Davidrp23/LoRa-Smart-Irrigation-Network/docs/ExplanationDiagrams/DataTransmission_Unrecognized.pdf

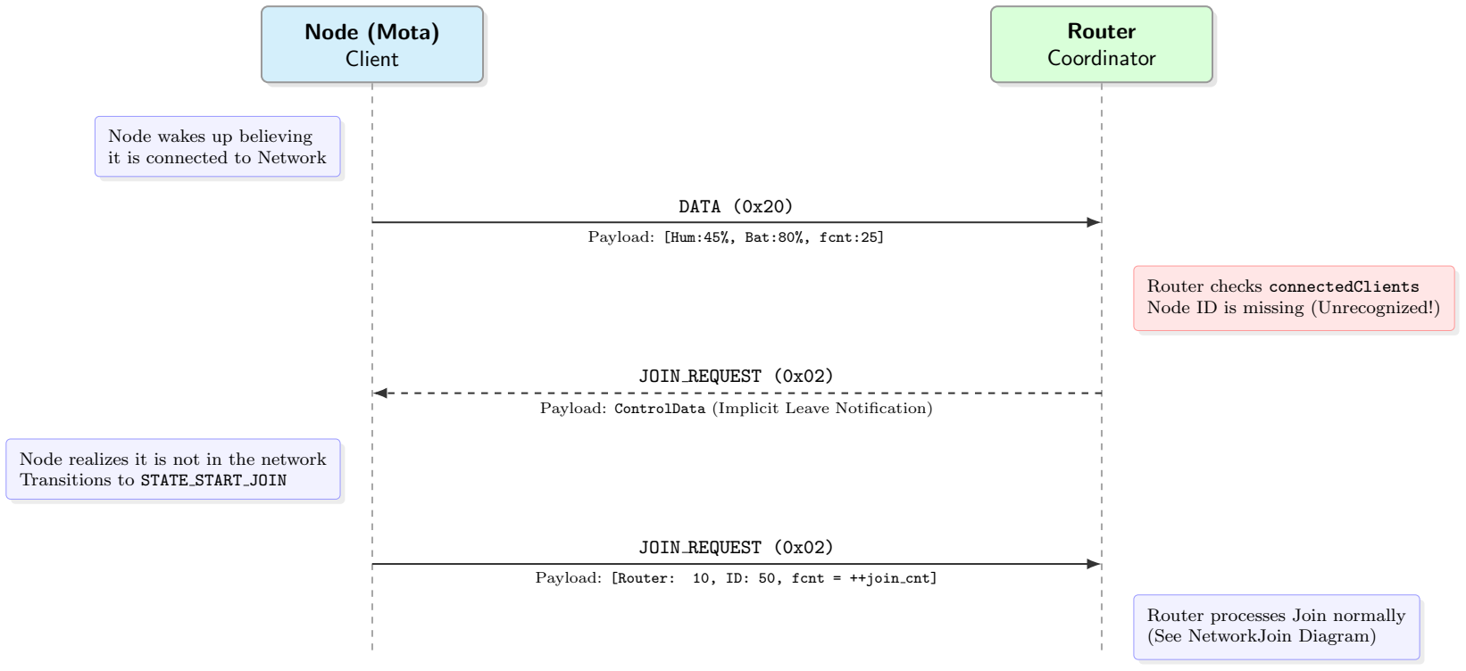
[picture p2: figure]
Node (Mota) Client; Router Coordinator; Node wakes up believing it is connected to Network; DATA (0x20); Payload: [Hum:45%, Bat:80%, fcnt:25]; Router checks connectedClients Node ID is missing (Unrecognized!); JOIN REQUEST (0x02); Payload: ControlData (Implicit Leave Notification); Node realizes it is not in the network Transitions to STATE START JOIN; Router processes Join normally (See NetworkJoin Diagram)

Payload: [Router: 10, ID: 50, fcnt = ++join cnt]

* Note: Payloads are shown in JSON/Plain-text format for clarity, but are transmitted as packed C-structs over LoRa to minimize time-on-air, battery usage, and collision probability.
