Davidrp23/LoRa-Smart-Irrigation-Network/docs/ExplanationDiagrams/esquemaProductorConsumidor.pdf

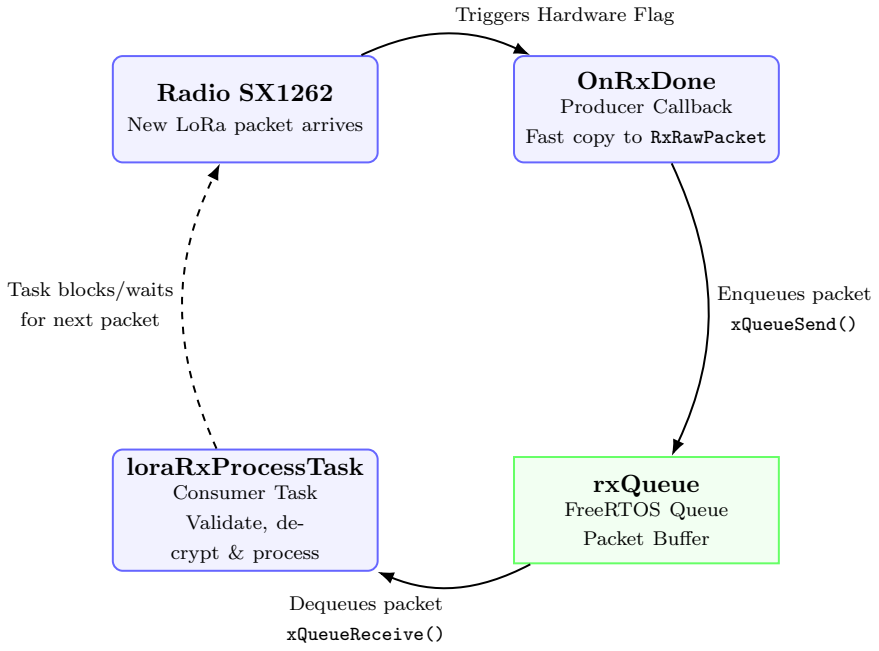
[picture p3: figure]
Radio SX1262; New LoRa packet arrives; OnRxDone; Producer Callback; Fast copy to RxRawPacket; rxQueue; FreeRTOS Queue; Packet Buffer; loraRxProcessTask; Consumer Task; Validate, de-; crypt & process; Triggers Hardware Flag; Enqueues packet; xQueueSend(); Dequeues packet; xQueueReceive(); Task blocks/waits; for next packet
