Davidrp23/LoRa-Smart-Irrigation-Network/docs/ExplanationDiagrams/LoRaMessageFrame.pdf

HEADER (8 bytes — plaintext) | PAYLOAD (up to 50 bytes — AES-128-CTR encrypted)
type | length | fcnt | checksum | data (union)
B0 | B1 | B2 | B6 | B8 | B57
1 B | 1 B | 4 B | 2 B | ≤50 B
Field | Type | Description
type | messageType (1 B) | Message kind: tells the receiver how to parse data
length | uint8 t | (1 B) | Valid bytes in data. Enables dynamic-length transmissions
fcnt | uint32 t (4 B) | Frame Counter: anti-replay guard and AES-128 IV source
checksum | uint16 t (2 B) | | Packet integrity check against RF corruption
data | union | (≤50 B) | Encrypted payload. Structure depends on type

Only bytes B0–B(8+length−1) are transmitted over the air. Unused trailing bytes in data are discarded before sending.
