Davidrp23/LoRa-Smart-Irrigation-Network/docs/photos/Proxmox/flora-system-sumary.png

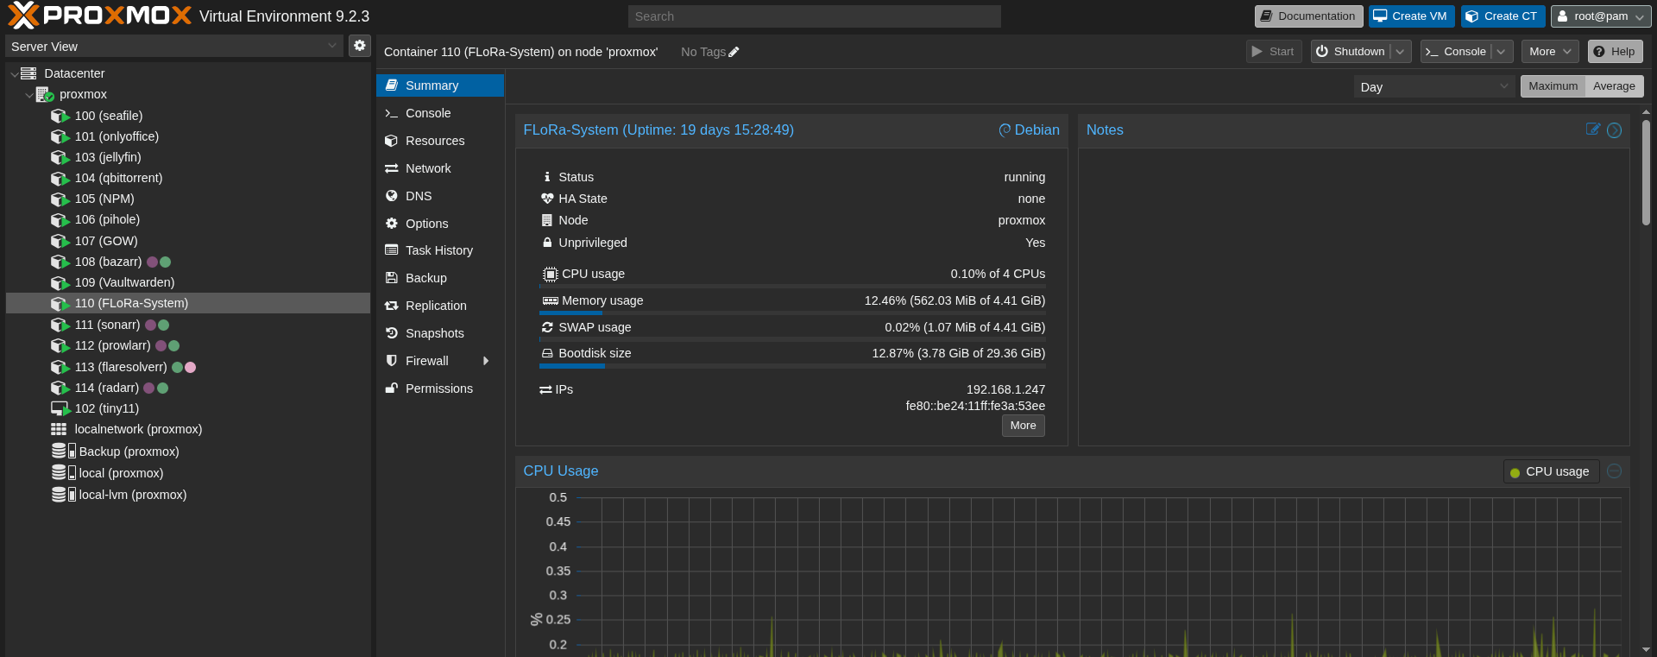
docs/photos/Proxmox/flora-system-sumary.png
