Davidrp23/LoRa-Smart-Irrigation-Network/docs/photos/Proxmox/npm/certificadosSSLConfDominioFlora.png

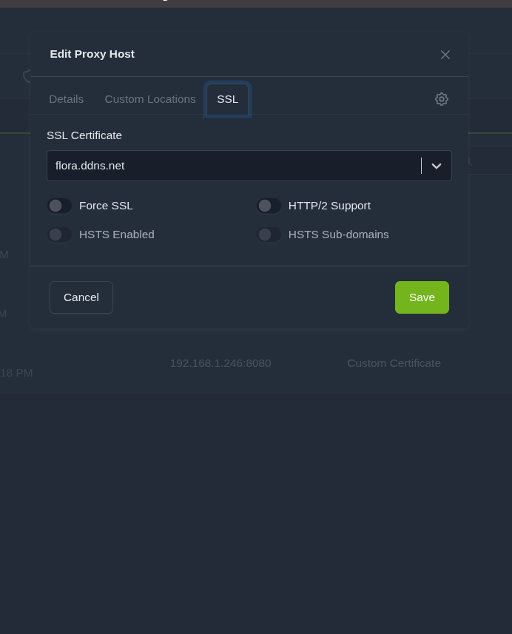
docs/photos/Proxmox/npm/certificadosSSLConfDominioFlora.png
