Davidrp23/LoRa-Smart-Irrigation-Network/docs/photos/Proxmox/npm/letsEncrypt.png

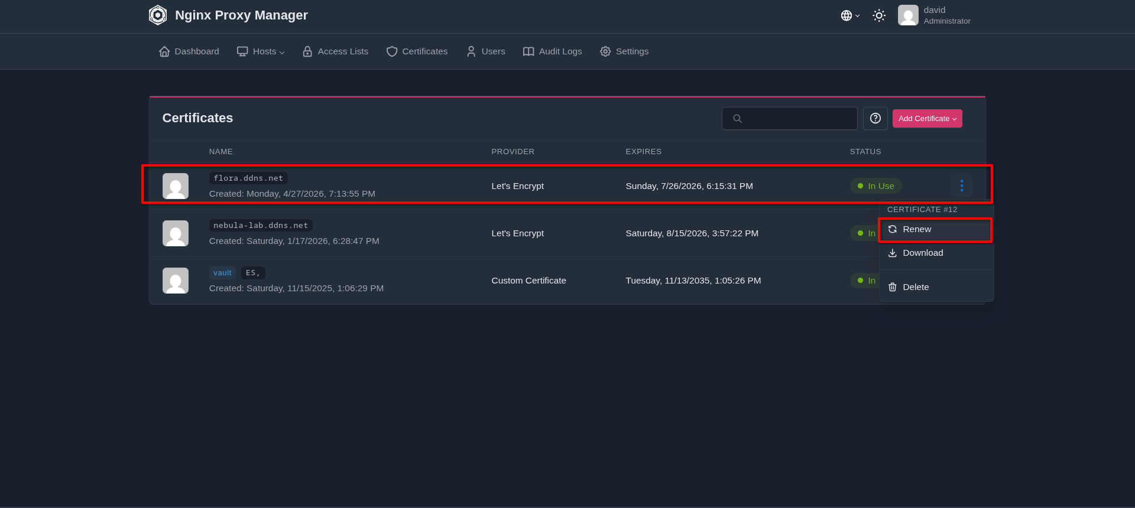
docs/photos/Proxmox/npm/letsEncrypt.png
