Davidrp23/LoRa-Smart-Irrigation-Network/docs/photos/Proxmox/npm/proxyHostSumary.png

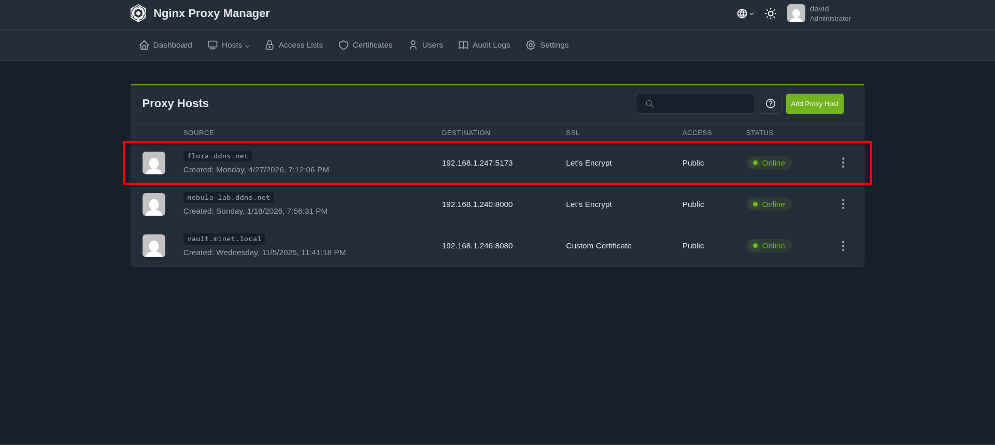
docs/photos/Proxmox/npm/proxyHostSumary.png
