Davidrp23/LoRa-Smart-Irrigation-Network/docs/photos/Proxmox/npm/rutasNPM.png

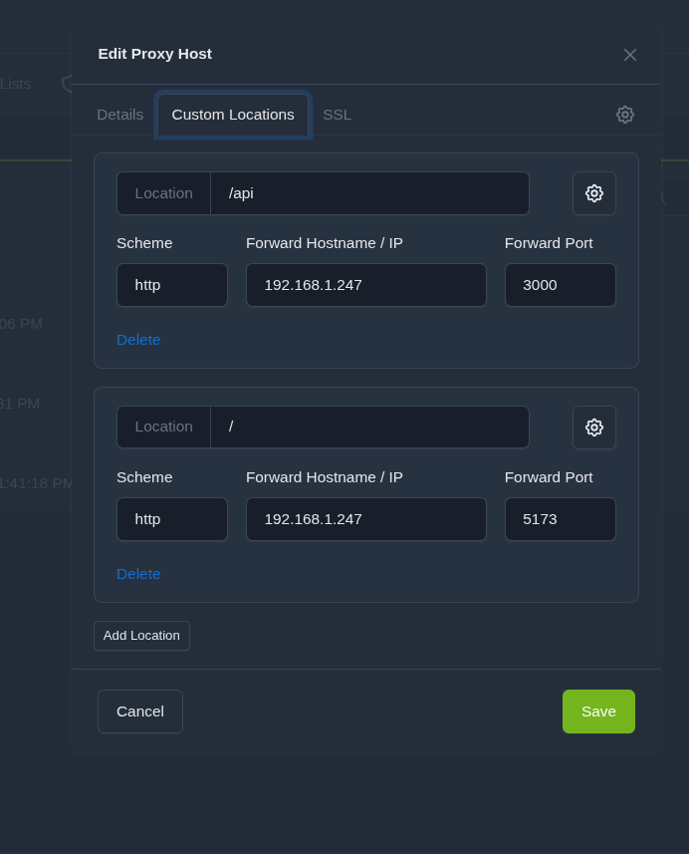
docs/photos/Proxmox/npm/rutasNPM.png
