Davidrp23/LoRa-Smart-Irrigation-Network/docs/photos/Proxmox/nvidia-smi.png

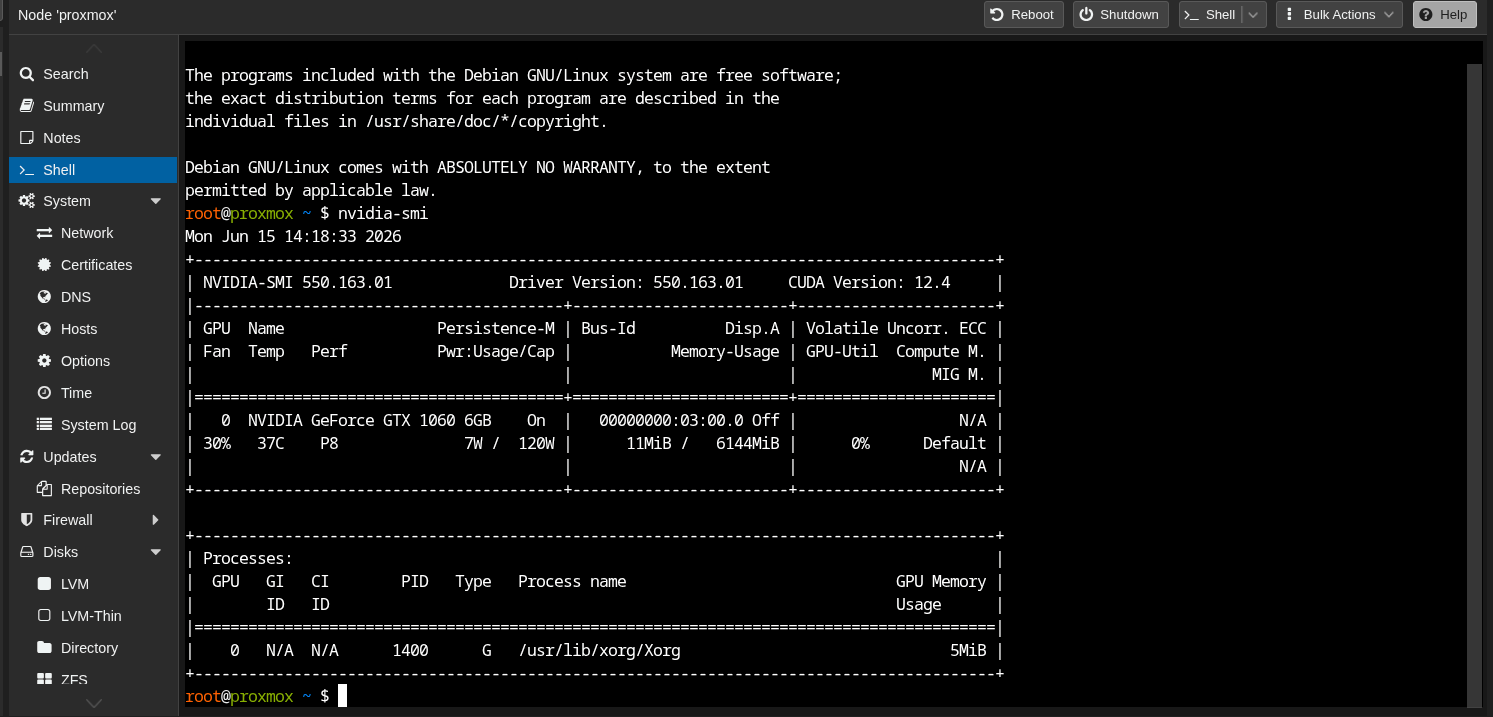
docs/photos/Proxmox/nvidia-smi.png
