Davidrp23/LoRa-Smart-Irrigation-Network/docs/photos/Proxmox/pm2.png

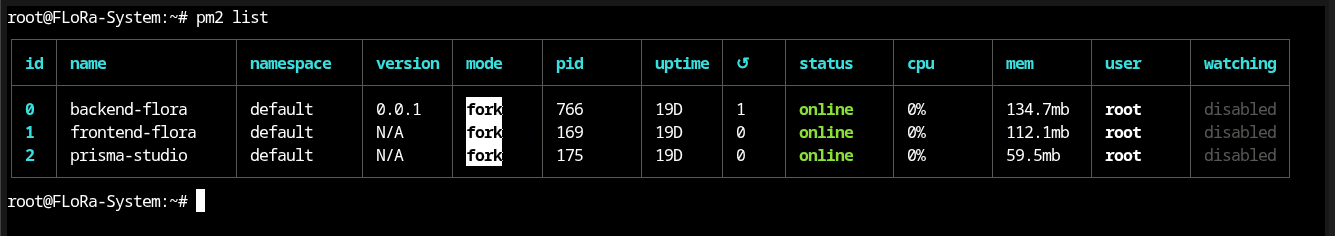
docs/photos/Proxmox/pm2.png
