Davidrp23/LoRa-Smart-Irrigation-Network/docs/photos/Proxmox/Server.png

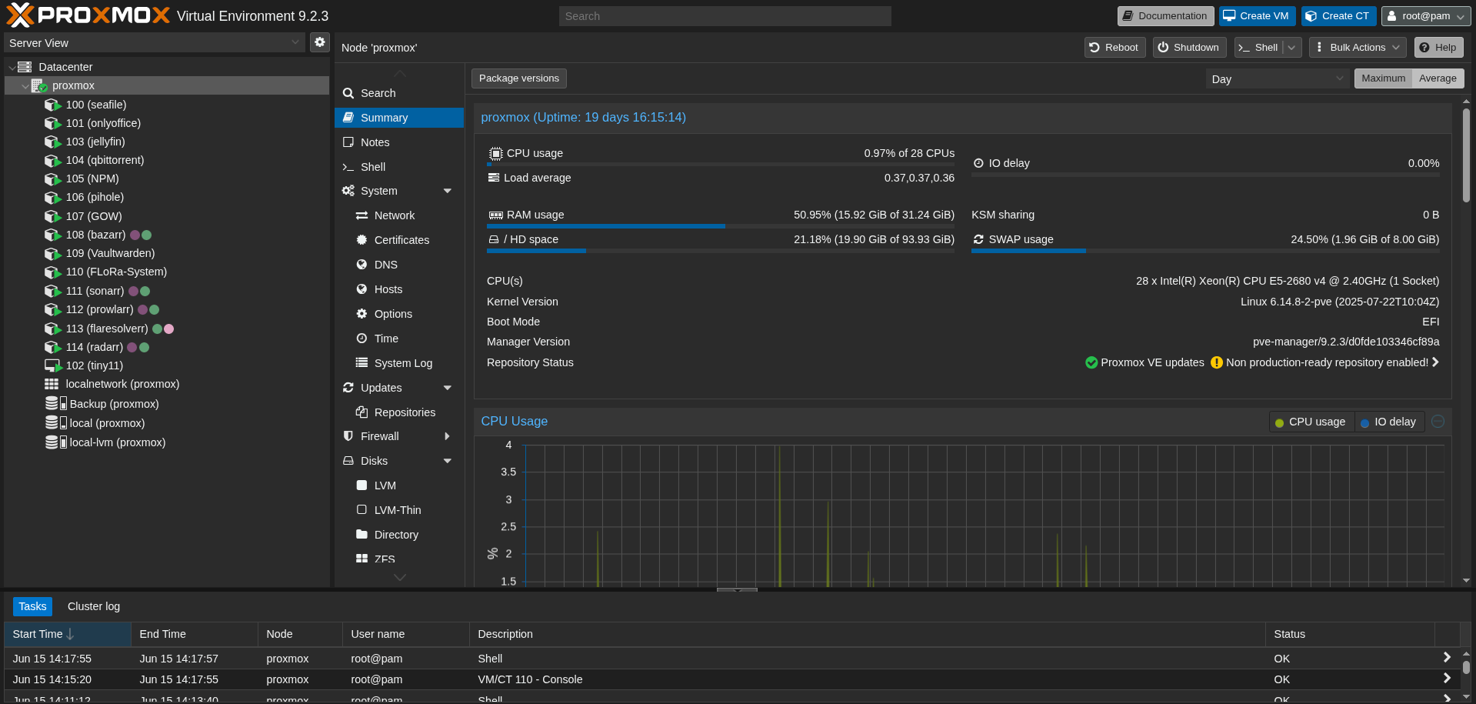
docs/photos/Proxmox/Server.png
