Davidrp23/LoRa-Smart-Irrigation-Network/docs/photos/WEB_UI/DARK/pasted file12.png

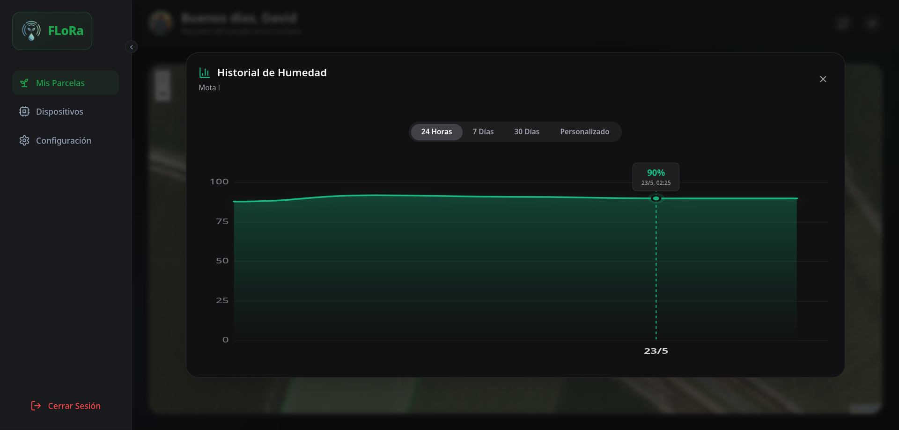
docs/photos/WEB_UI/DARK/pasted file12.png
