Davidrp23/LoRa-Smart-Irrigation-Network/docs/photos/WEB_UI/DARK/Screenshot_20260523_111758.png

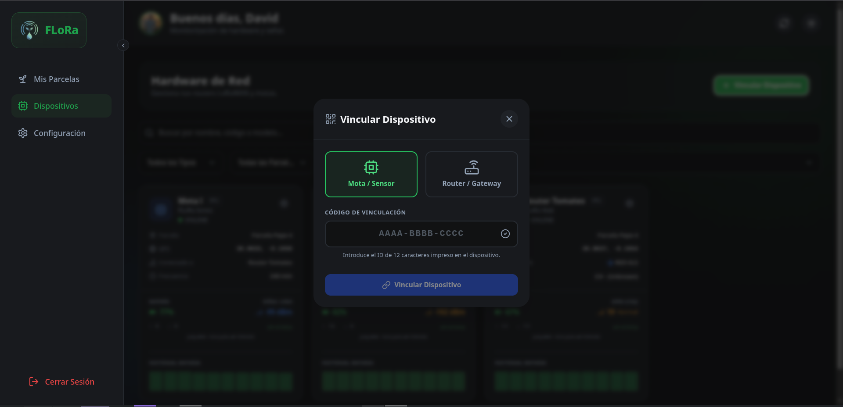
docs/photos/WEB_UI/DARK/Screenshot_20260523_111758.png
