Davidrp23/LoRa-Smart-Irrigation-Network/docs/photos/WEB_UI/DARK/Screenshot_20260601_191418.png

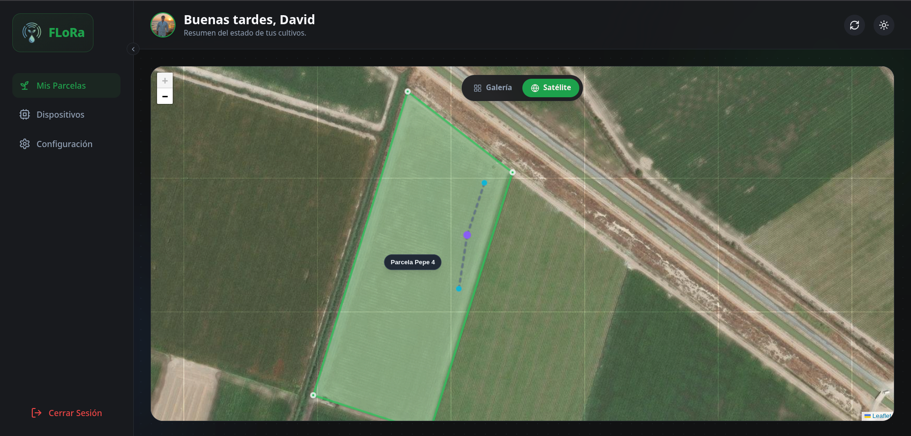
docs/photos/WEB_UI/DARK/Screenshot_20260601_191418.png
