Davidrp23/LoRa-Smart-Irrigation-Network/docs/photos/WEB_UI/DARK/Screenshot_20260615_121557.png

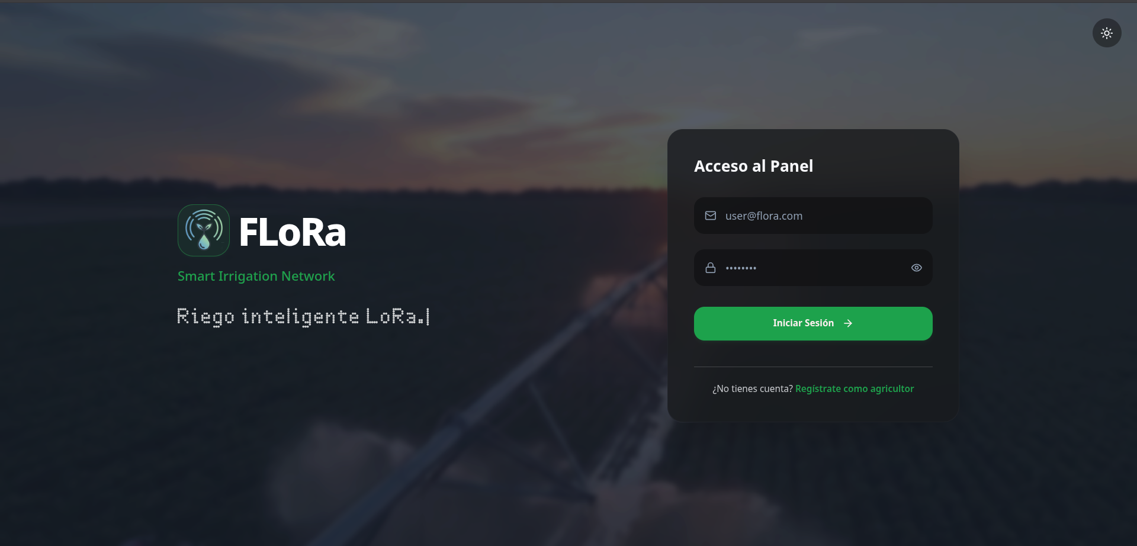
docs/photos/WEB_UI/DARK/Screenshot_20260615_121557.png
