Davidrp23/LoRa-Smart-Irrigation-Network/docs/photos/WEB_UI/LIGHT/Screenshot_20260615_124416.png

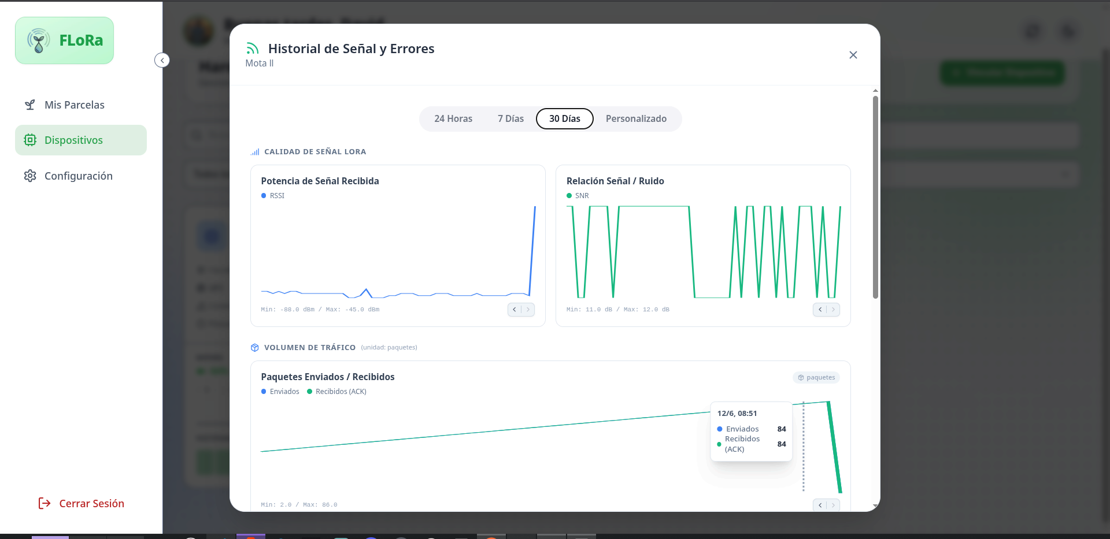
docs/photos/WEB_UI/LIGHT/Screenshot_20260615_124416.png
