Davidrp23/LoRa-Smart-Irrigation-Network/docs/ReporteFotograficoInstalacionCampo/Collage1.jpg

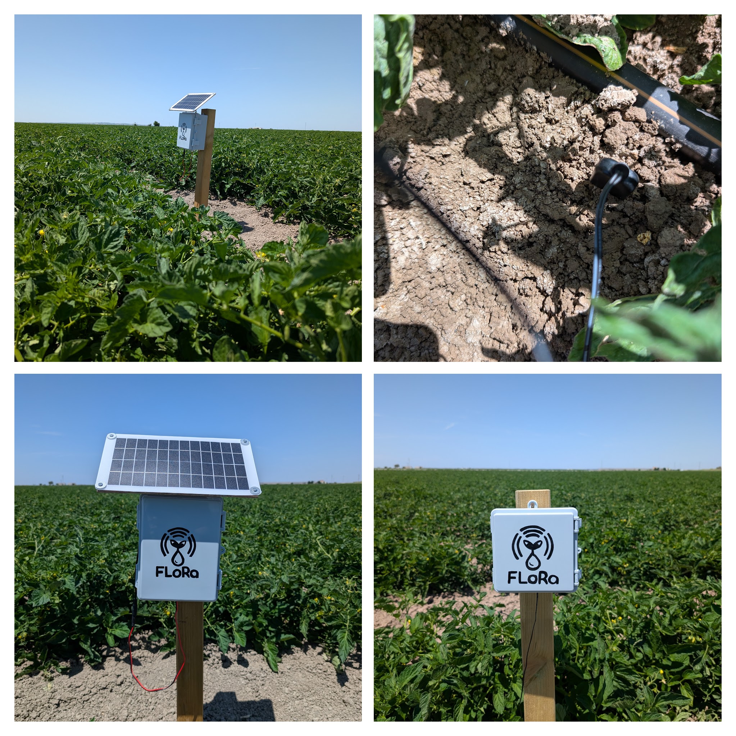
docs/ReporteFotograficoInstalacionCampo/Collage1.jpg
