Davidrp23/LoRa-Smart-Irrigation-Network/docs/ReporteFotograficoInstalacionCampo/collage2.jpg

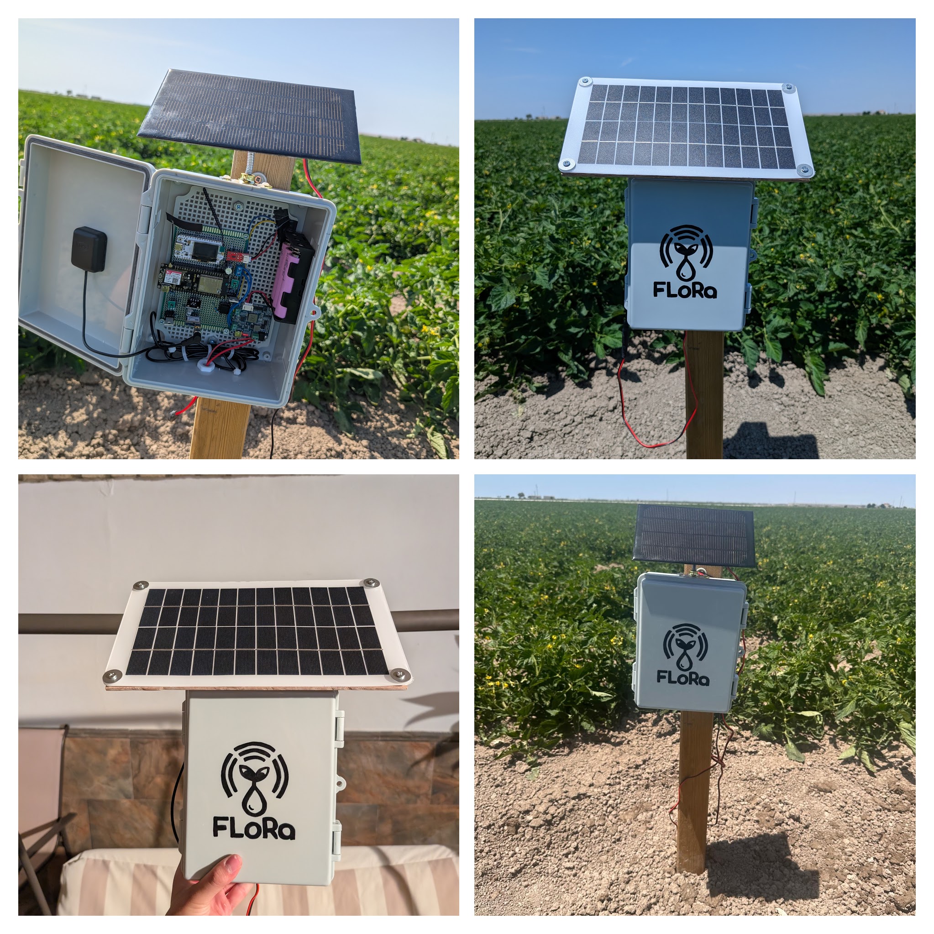
docs/ReporteFotograficoInstalacionCampo/collage2.jpg
