Davidrp23/LoRa-Smart-Irrigation-Network/docs/ReporteFotograficoInstalacionCampo/collage3.jpg

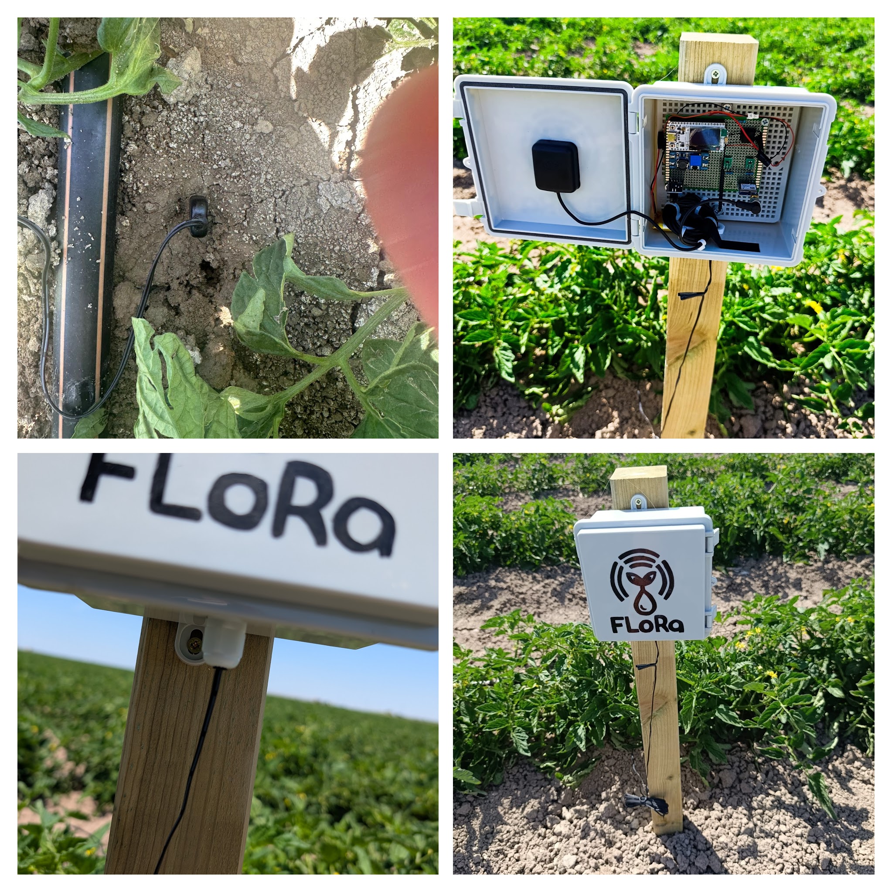
docs/ReporteFotograficoInstalacionCampo/collage3.jpg
