Davidrp23/LoRa-Smart-Irrigation-Network/docs/ReporteFotograficoInstalacionCampo/IMG-20260522-WA0014.jpg

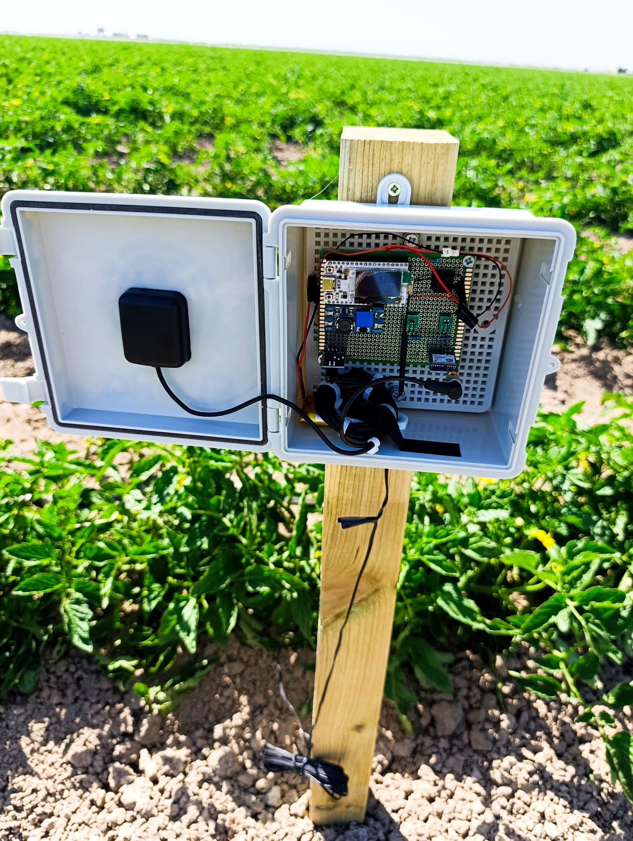
docs/ReporteFotograficoInstalacionCampo/IMG-20260522-WA0014.jpg
