Davidrp23/LoRa-Smart-Irrigation-Network/docs/ReporteFotograficoInstalacionCampo/PXL_20260522_151446291.jpg

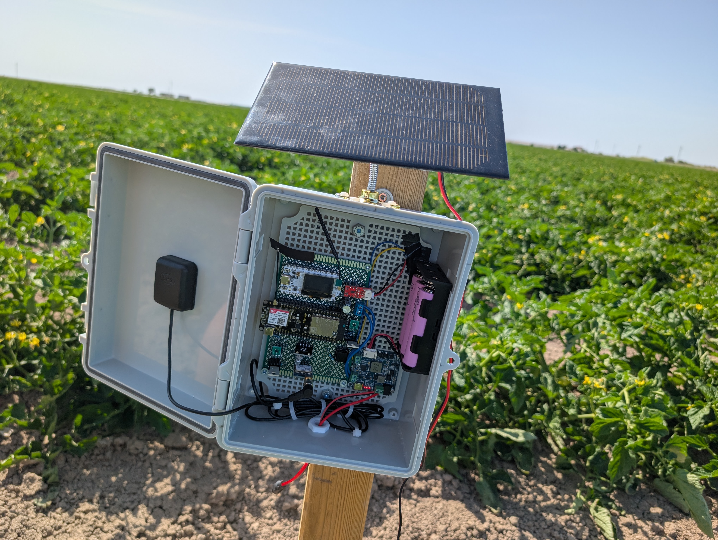
docs/ReporteFotograficoInstalacionCampo/PXL_20260522_151446291.jpg
