Davidrp23/LoRa-Smart-Irrigation-Network/docs/ReporteFotograficoInstalacionCampo/PXL_20260527_204551264.jpg

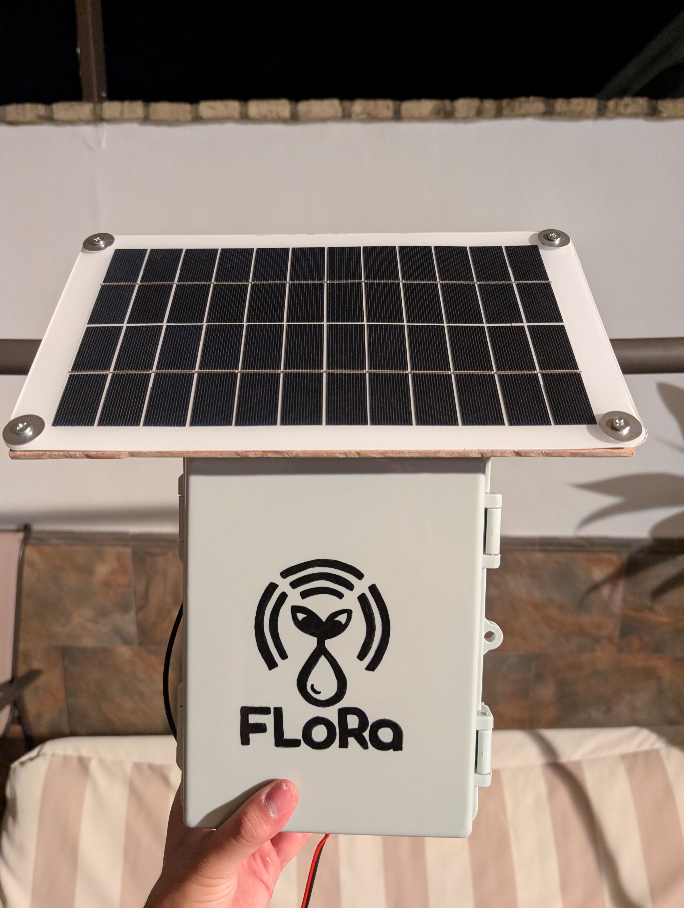
docs/ReporteFotograficoInstalacionCampo/PXL_20260527_204551264.jpg
