Davidrp23/LoRa-Smart-Irrigation-Network/docs/ReporteFotograficoInstalacionCampo/PXL_20260528_112710383.jpg

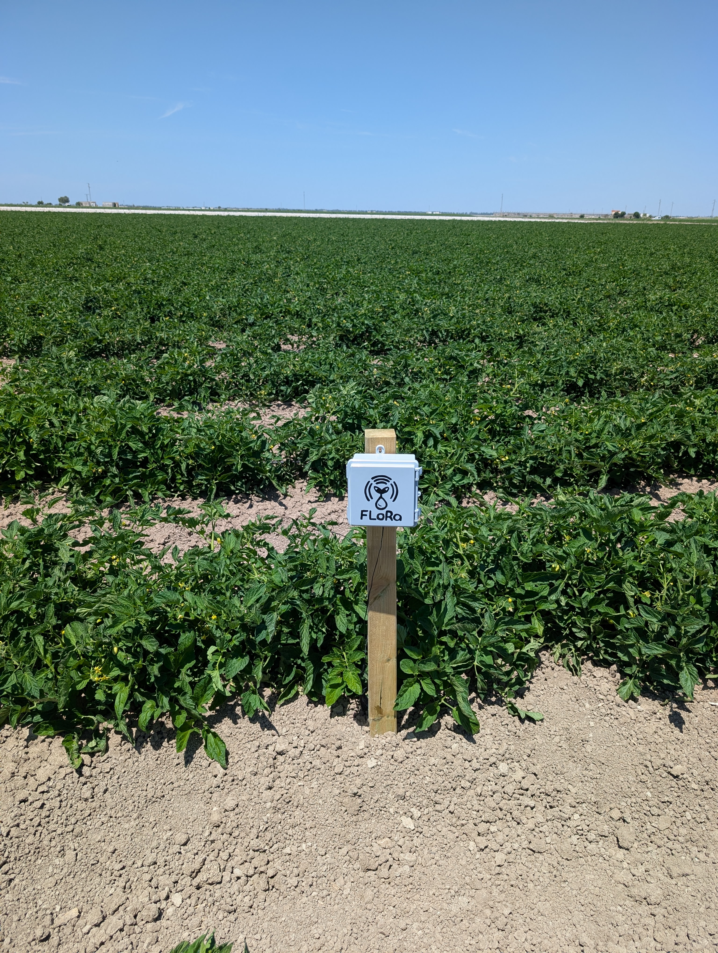
docs/ReporteFotograficoInstalacionCampo/PXL_20260528_112710383.jpg
