Davidrp23/LoRa-Smart-Irrigation-Network/docs/ReporteFotograficoInstalacionCampo/PXL_20260528_112723518.MP.jpg

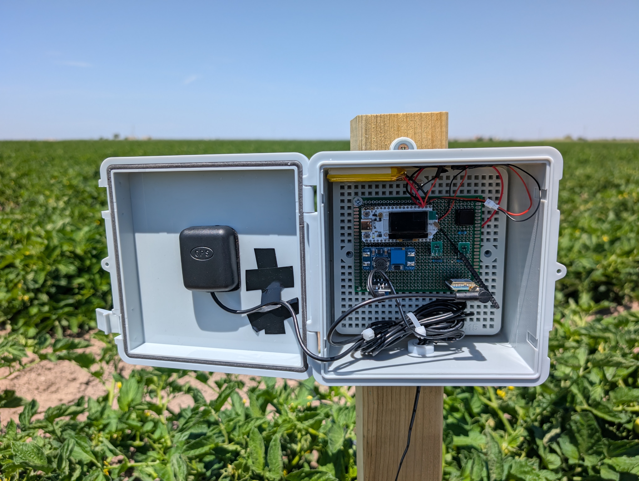
docs/ReporteFotograficoInstalacionCampo/PXL_20260528_112723518.MP.jpg
