Davidrp23/LoRa-Smart-Irrigation-Network/docs/ReporteFotograficoInstalacionCampo/PXL_20260528_112731561.MP.jpg

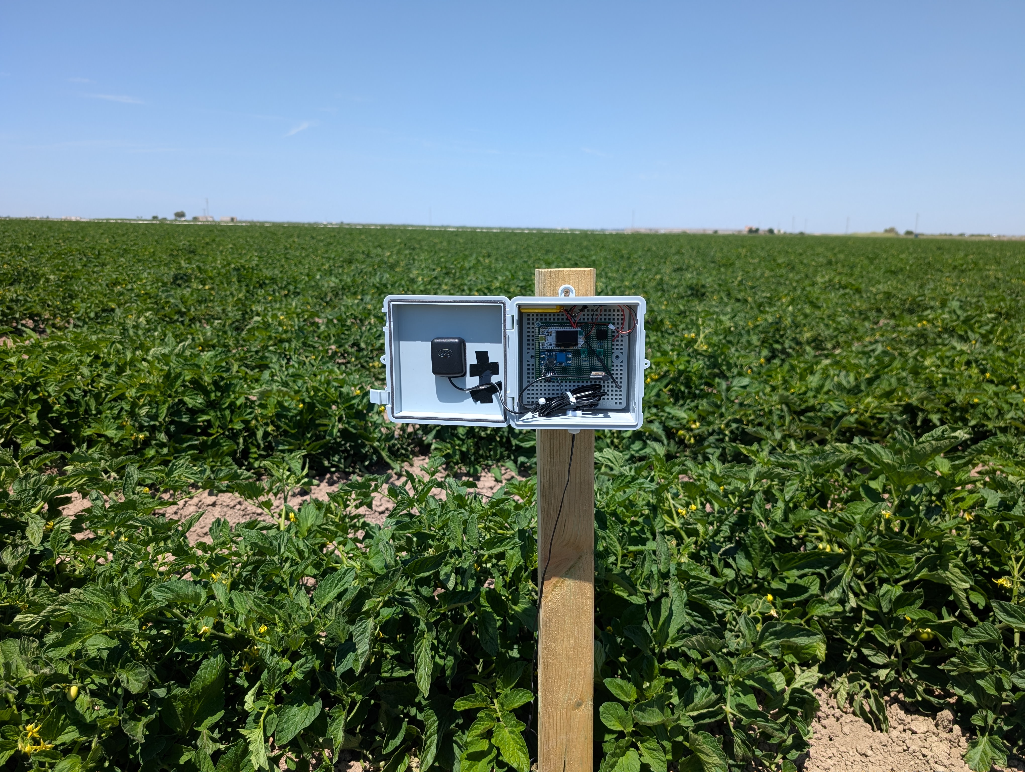
docs/ReporteFotograficoInstalacionCampo/PXL_20260528_112731561.MP.jpg
