Davidrp23/LoRa-Smart-Irrigation-Network/docs/ReporteFotograficoInstalacionCampo/PXL_20260528_112928310.jpg

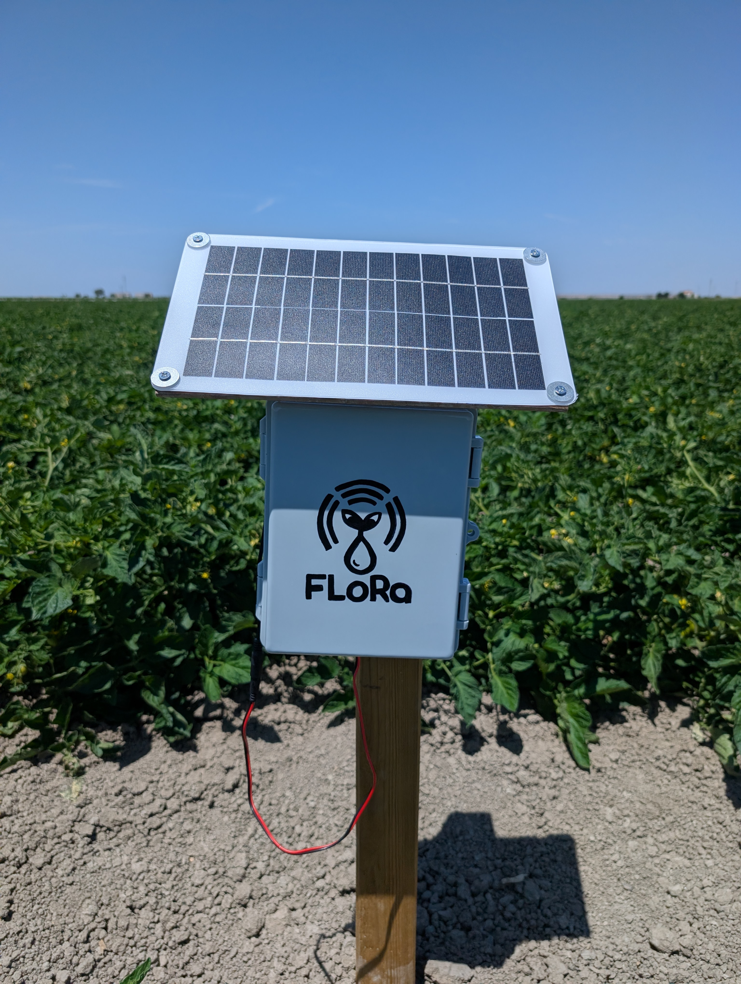
docs/ReporteFotograficoInstalacionCampo/PXL_20260528_112928310.jpg
