Davidrp23/LoRa-Smart-Irrigation-Network/docs/ReporteFotograficoInstalacionCampo/PXL_20260528_113030355.MP.jpg

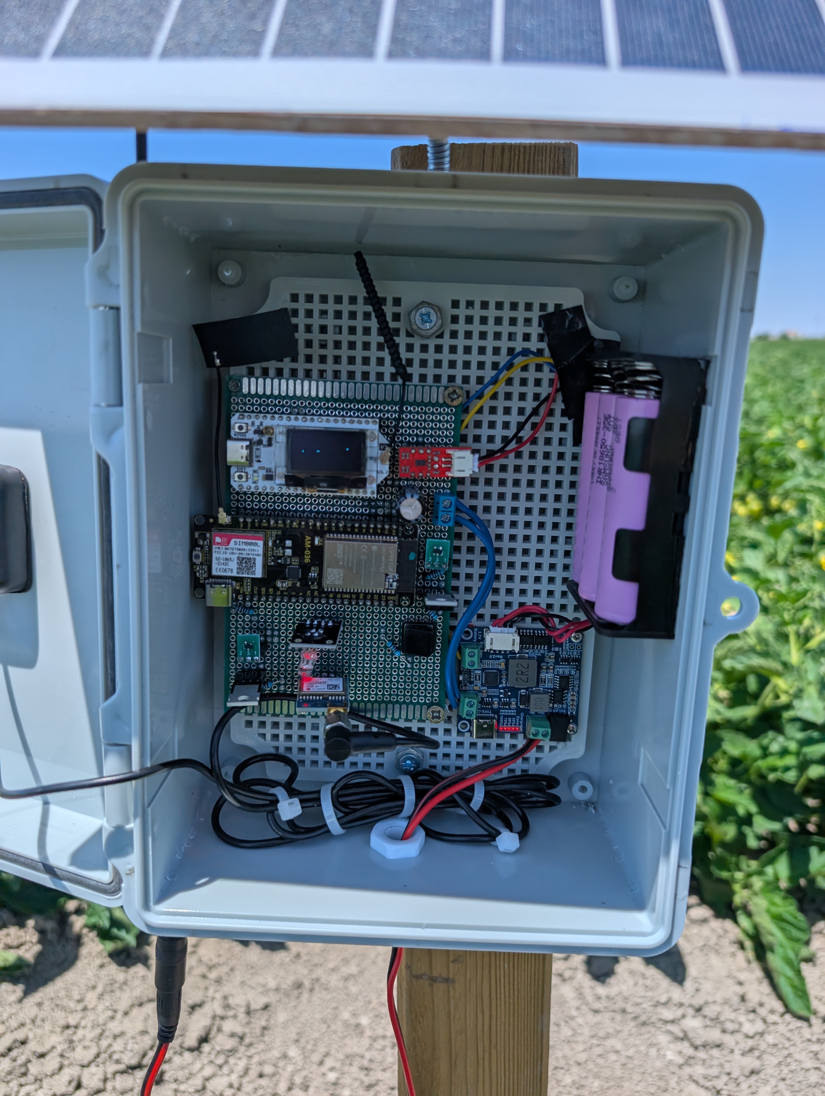
docs/ReporteFotograficoInstalacionCampo/PXL_20260528_113030355.MP.jpg
