Davidrp23/LoRa-Smart-Irrigation-Network/docs/ReporteFotograficoInstalacionCampo/PXL_20260528_113207992.MP.jpg

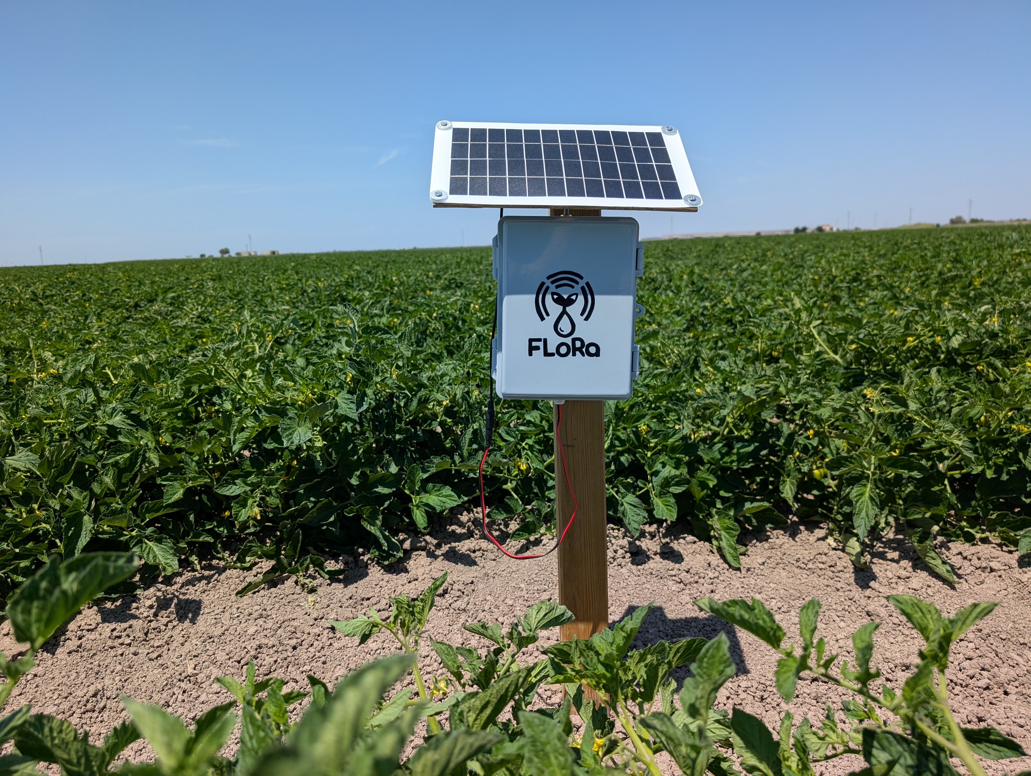
docs/ReporteFotograficoInstalacionCampo/PXL_20260528_113207992.MP.jpg
