Davidrp23/LoRa-Smart-Irrigation-Network/docs/ReporteFotograficoInstalacionCampo/PXL_20260528_113353432.jpg

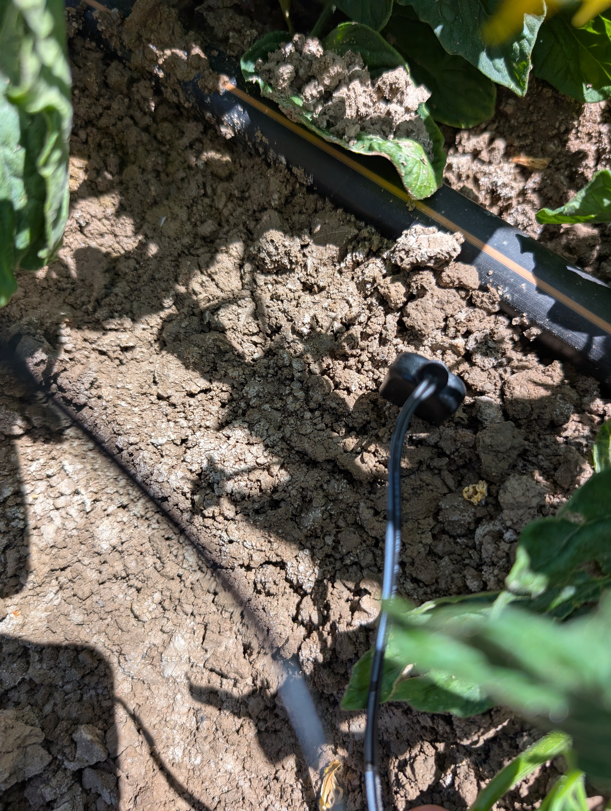
docs/ReporteFotograficoInstalacionCampo/PXL_20260528_113353432.jpg
