Davidrp23/LoRa-Smart-Irrigation-Network/docs/ReporteFotograficoInstalacionCampo/PXL_20260528_113442099.jpg

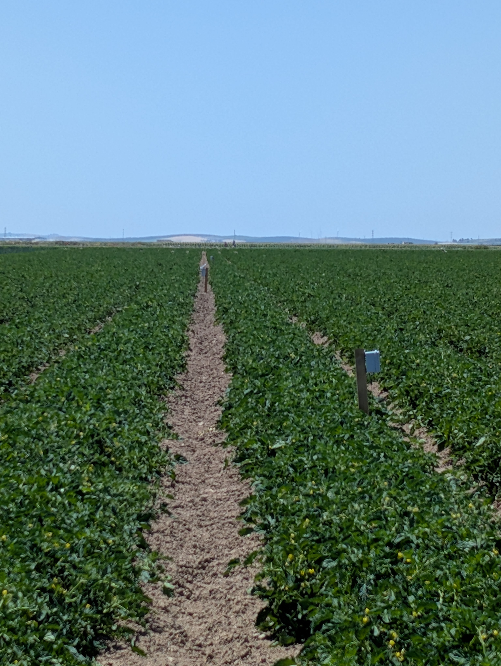
docs/ReporteFotograficoInstalacionCampo/PXL_20260528_113442099.jpg
