Davidrp23/LoRa-Smart-Irrigation-Network/docs/ReporteFotograficoInstalacionCampo/PXL_20260528_184345490.MP.jpg

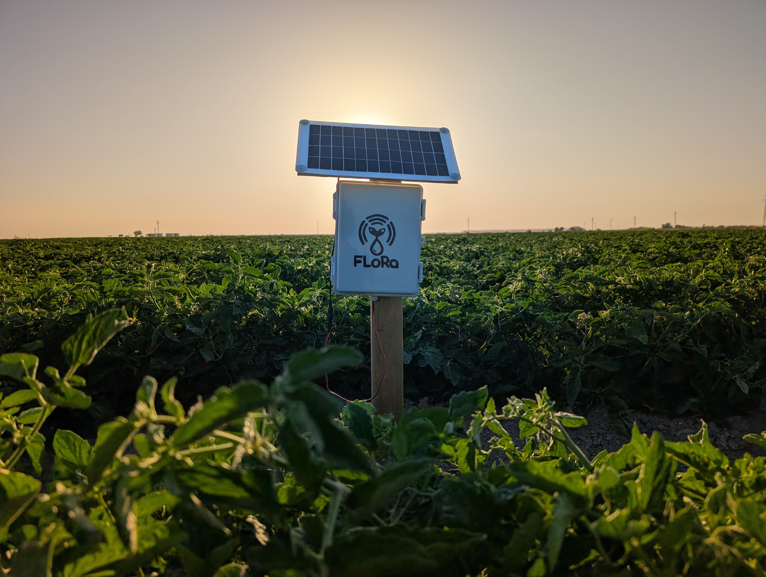
docs/ReporteFotograficoInstalacionCampo/PXL_20260528_184345490.MP.jpg
