Davidrp23/LoRa-Smart-Irrigation-Network/docs/ReporteFotograficoInstalacionCampo/PXL_20260528_184729856.jpg

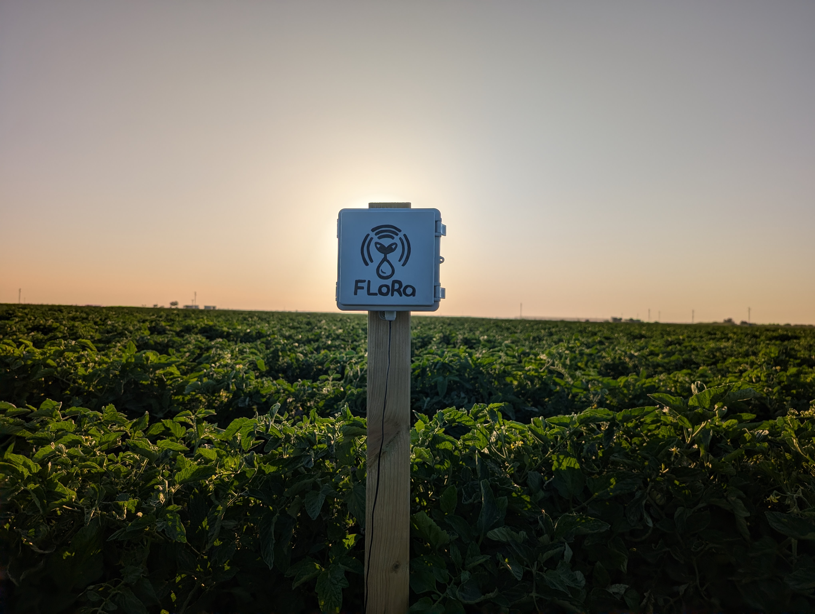
docs/ReporteFotograficoInstalacionCampo/PXL_20260528_184729856.jpg
