Davidrp23/LoRa-Smart-Irrigation-Network/docs/ReporteFotograficoInstalacionCampo/PXL_20260607_190223759.jpg

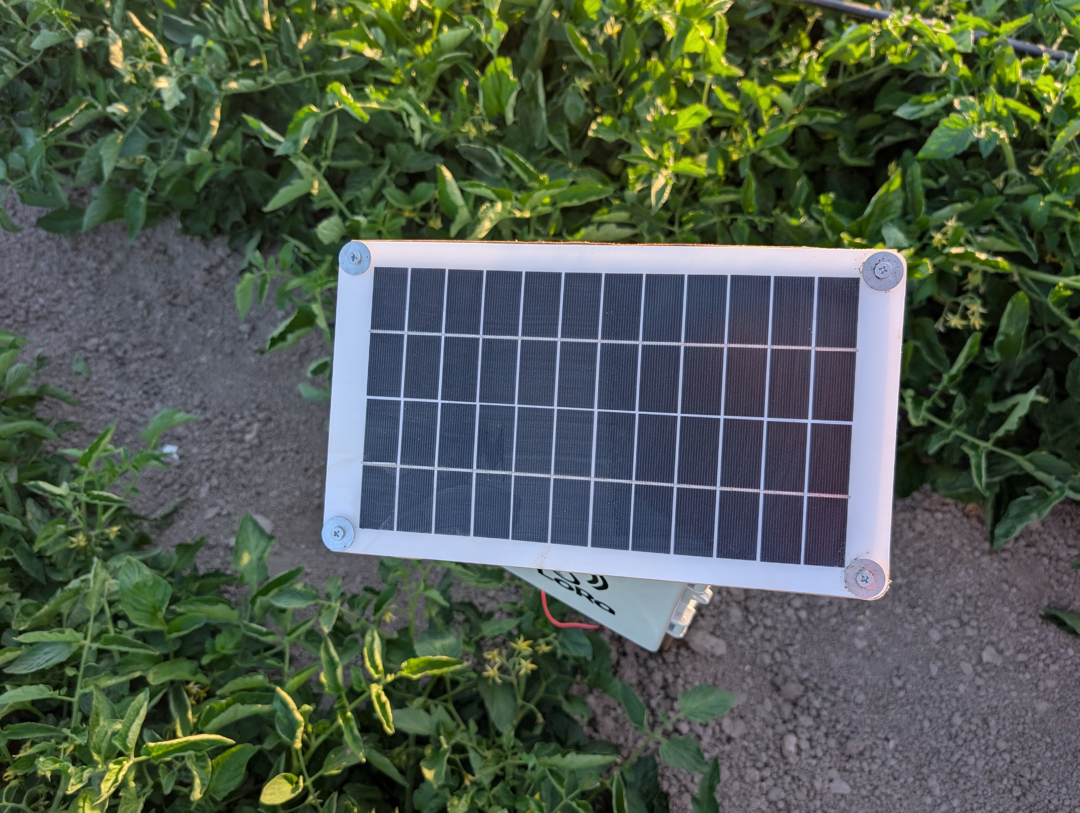
docs/ReporteFotograficoInstalacionCampo/PXL_20260607_190223759.jpg
