Davidrp23/LoRa-Smart-Irrigation-Network/docs/SerialTest/SerialWorkingOutput.png

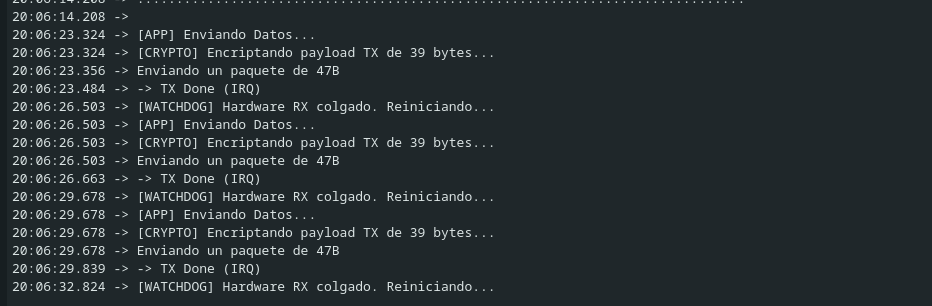
docs/SerialTest/SerialWorkingOutput.png
