Davidrp23/LoRa-Smart-Irrigation-Network/docs/ExplanationDiagrams/AM036_Protocol_2.pdf

## Heltec ESP32 + LoRa + OLED

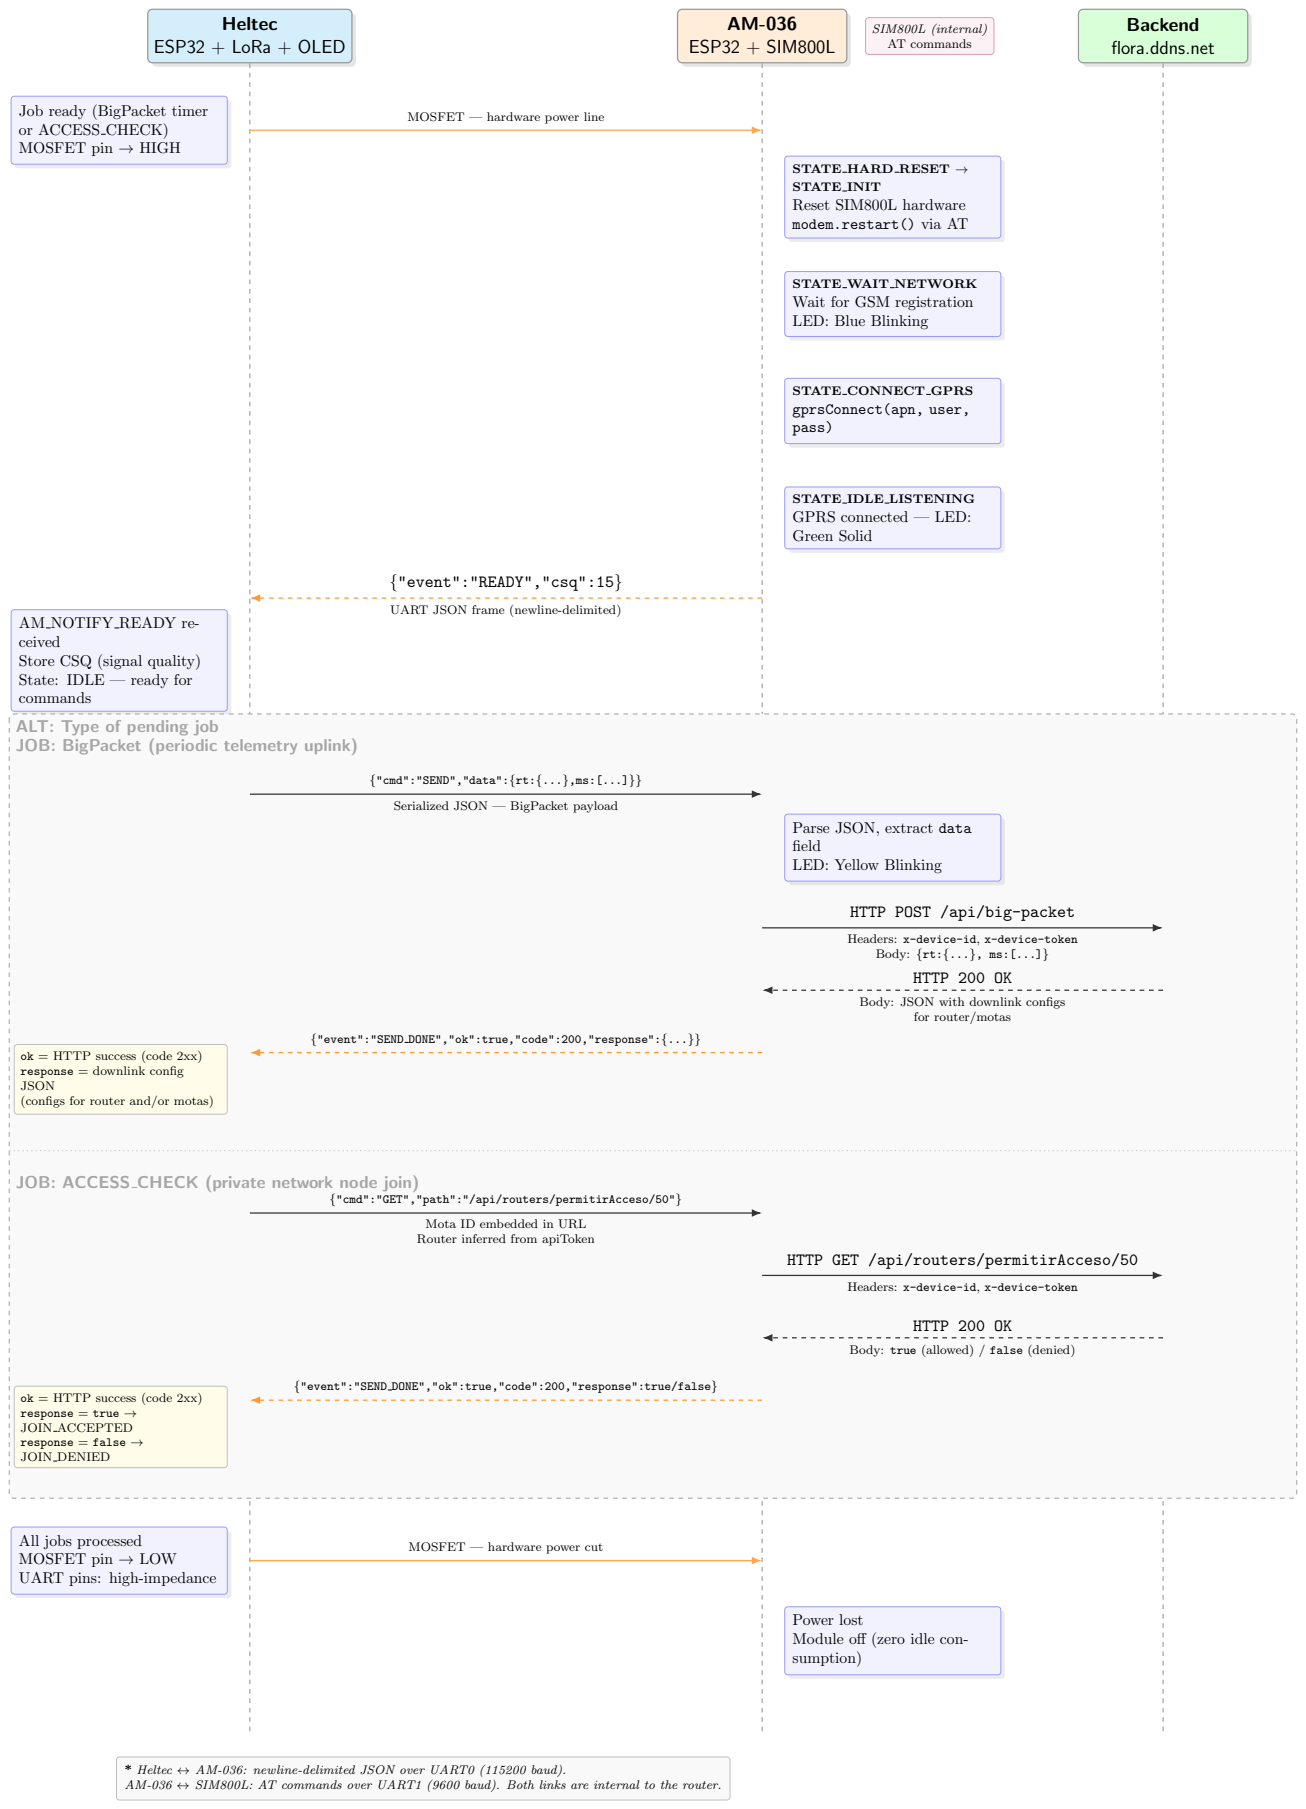
[picture p87: page 1]
AM-036 ESP32 + SIM800L; SIM800L (internal) AT commands; HTTP 200 OK

Backend
flora.ddns.net

Job ready (BigPacket timer
or ACCESS CHECK)
MOSFET pin → HIGH

MOSFET — hardware power line

STATE HARD RESET →
STATE INIT
Reset SIM800L hardware
modem.restart() via AT

STATE WAIT NETWORK
Wait for GSM registration
LED: Blue Blinking

STATE CONNECT GPRS
gprsConnect(apn, user,
pass)

STATE IDLE LISTENING
GPRS connected — LED:
Green Solid

{"event":"READY","csq":15}

UART JSON frame (newline-delimited)

AM NOTIFY READY re-
ceived
Store CSQ (signal quality)
State: IDLE — ready for
commands
ALT: Type of pending job
JOB: BigPacket (periodic telemetry uplink)

{"cmd":"SEND","data":{rt:{...},ms:[...]}}

Serialized JSON — BigPacket payload

Parse JSON, extract data
field
LED: Yellow Blinking

HTTP POST /api/big-packet

Headers: x-device-id, x-device-token
Body: {rt:{...}, ms:[...]}
HTTP 200 OK

Body: JSON with downlink configs

for router/motas

{"event":"SEND DONE","ok":true,"code":200,"response":{...}}

ok = HTTP success (code 2xx)
response = downlink config
JSON
(configs for router and/or motas)

JOB: ACCESS CHECK (private network node join)

{"cmd":"GET","path":"/api/routers/permitirAcceso/50"}

Mota ID embedded in URL
Router inferred from apiToken

HTTP GET /api/routers/permitirAcceso/50

Body: true (allowed) / false (denied)

{"event":"SEND DONE","ok":true,"code":200,"response":true/false}

response = true →
JOIN ACCEPTED
response = false →
JOIN DENIED

All jobs processed
MOSFET pin → LOW
UART pins: high-impedance

MOSFET — hardware power cut

Power lost
Module off (zero idle con-
sumption)

* Heltec ↔ AM-036: newline-delimited JSON over UART0 (115200 baud).
AM-036 ↔ SIM800L: AT commands over UART1 (9600 baud). Both links are internal to the router.
