Davidrp23/LoRa-Smart-Irrigation-Network/docs/ExplanationDiagrams/DataTransmission.pdf

### Node (Mota) Client

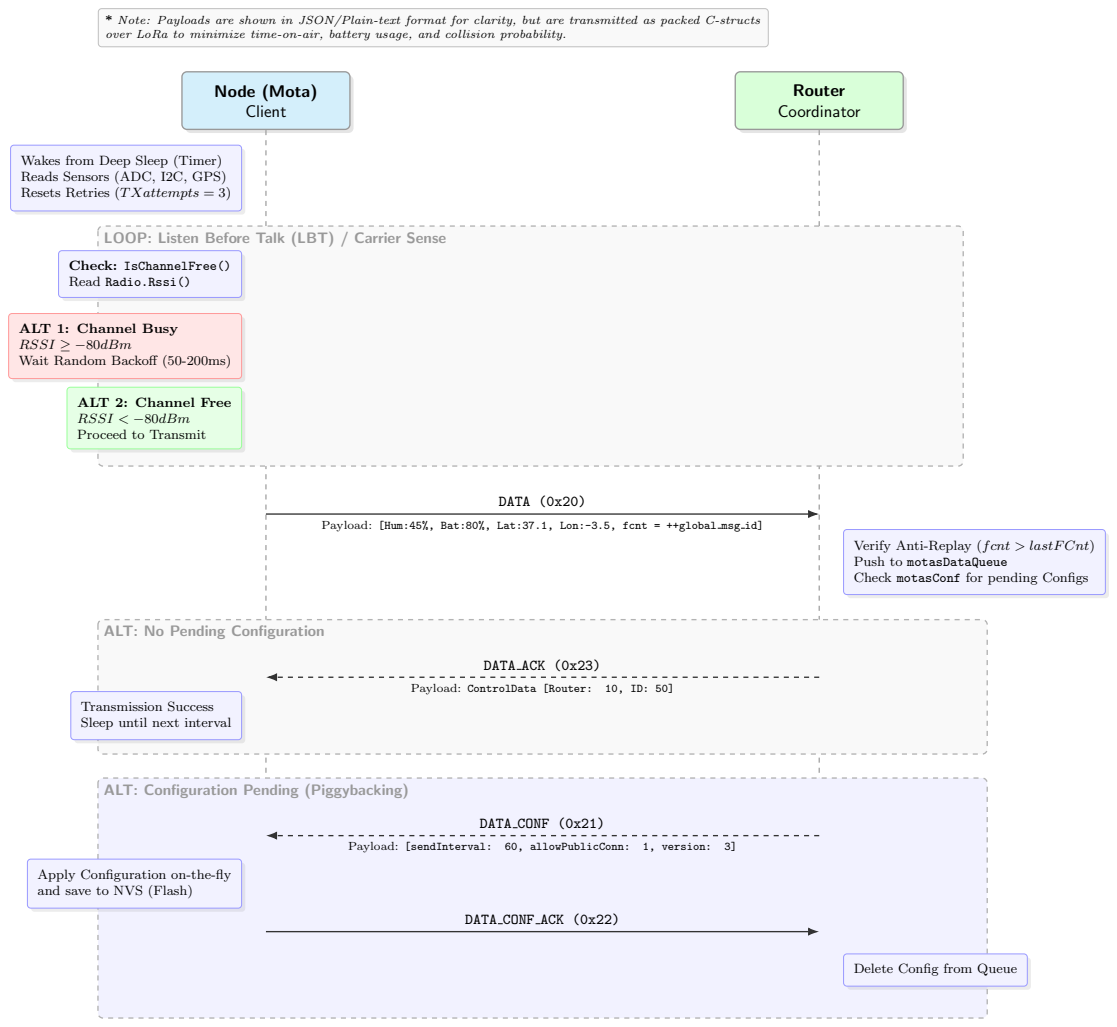
[picture p88: page 1]
Router Coordinator; DATA (0x20); DATA ACK (0x23); Payload: ControlData [Router:; DATA CONF (0x21); Payload: [sendInterval:; 60, allowPublicConn:; 1, version:

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

Wakes from Deep Sleep (Timer)
Reads Sensors (ADC, I2C, GPS)
Resets Retries (T Xattempts = 3)

LOOP: Listen Before Talk (LBT) / Carrier Sense

Check: IsChannelFree()
Read Radio.Rssi()

ALT 1: Channel Busy
RSSI ≥ −80dBm
Wait Random Backoff (50-200ms)

ALT 2: Channel Free
RSSI < −80dBm
Proceed to Transmit

Payload: [Hum:45%, Bat:80%, Lat:37.1, Lon:-3.5, fcnt = ++global msg id]

Verify Anti-Replay (fcnt > lastF Cnt)
Push to motasDataQueue
Check motasConf for pending Configs

ALT: No Pending Configuration

Transmission Success
Sleep until next interval

ALT: Configuration Pending (Piggybacking)

Apply Configuration on-the-fly
and save to NVS (Flash)

DATA CONF ACK (0x22)

Delete Config from Queue
