Davidrp23/LoRa-Smart-Irrigation-Network/docs/ExplanationDiagrams/esquemaAM036.pdf

# GPRS Communication Flow: Private Network Access Request

### LoRa Router

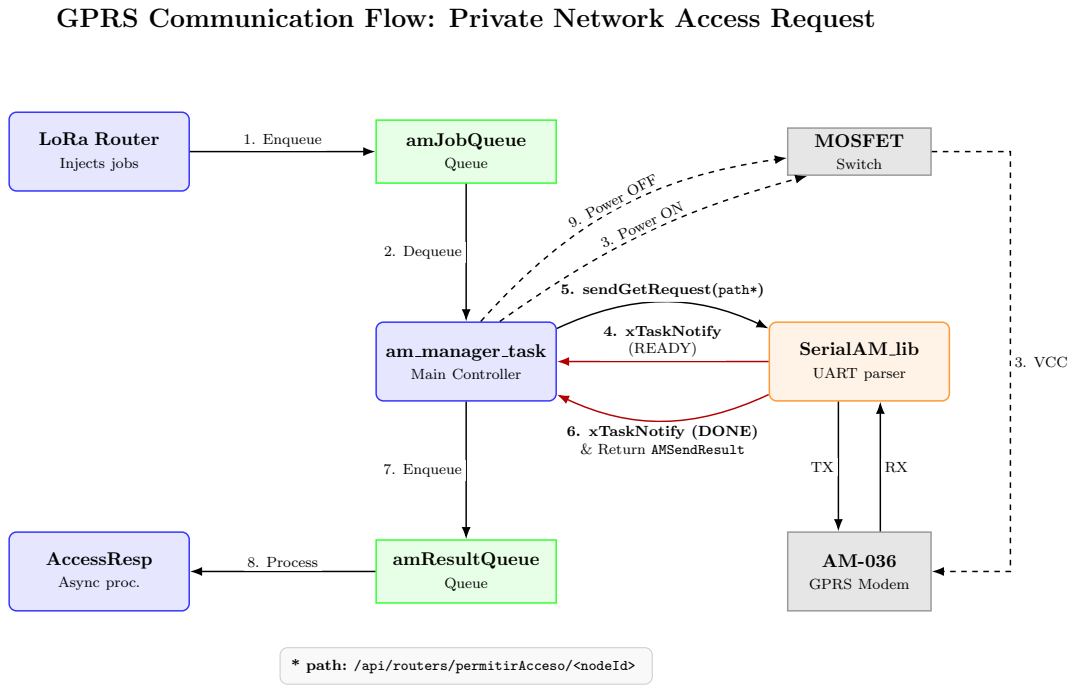
[picture p89: page 1]
Injects jobs; AccessResp; Async proc.; amJobQueue; Queue; amResultQueue; MOSFET; Switch; SerialAM lib; UART parser; GPRS Modem; 1. Enqueue; 2. Dequeue; 7. Enqueue; 8. Process; 4. xTaskNotify (READY); 5. sendGetRequest(path*); 6. xTaskNotify (DONE) & Return AMSendResult; 3. Power ON; 9. Power OFF; 3. VCC

am manager task
Main Controller

* path: /api/routers/permitirAcceso/<nodeId>
