Davidrp23/LoRa-Smart-Irrigation-Network/docs/ExplanationDiagrams/FlujoPrincipal.pdf

## Sensor Node (Mota)

## Router

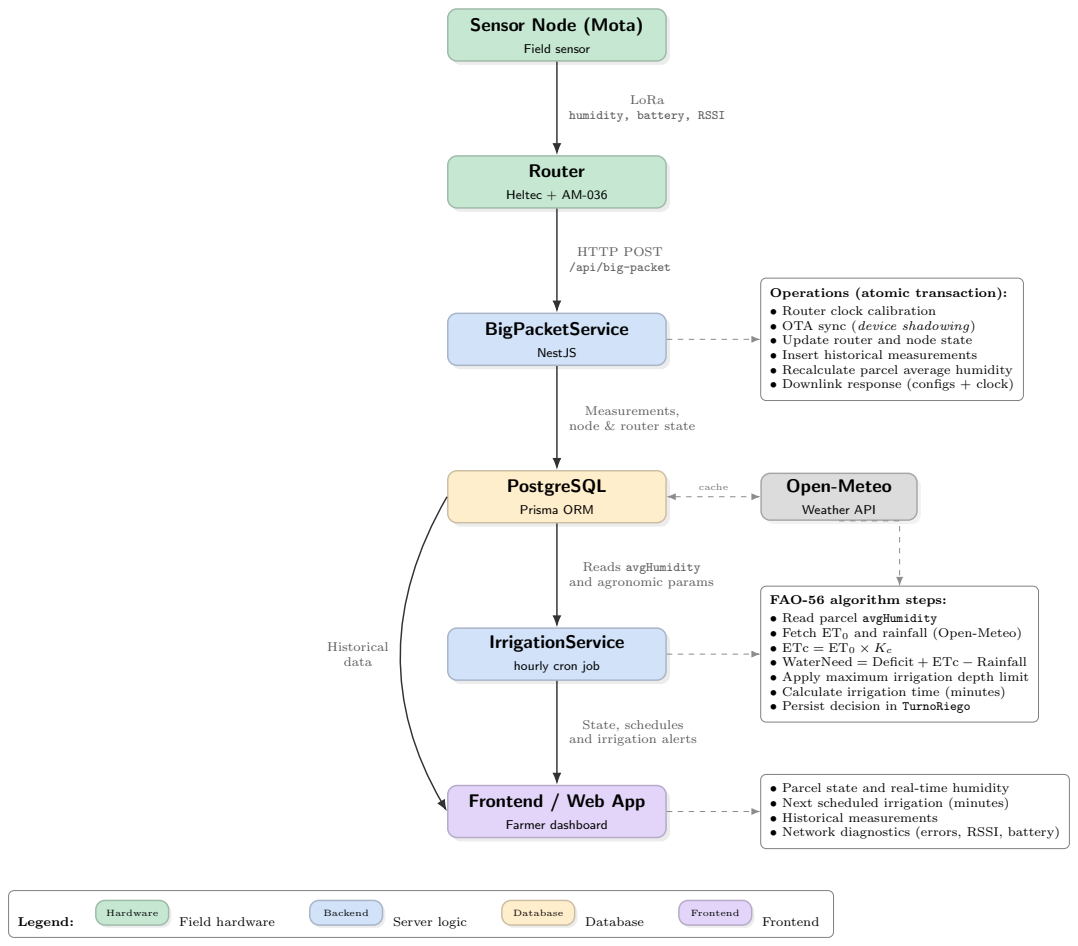
[picture p90: page 1]
Field sensor; Heltec + AM-036; LoRa; BigPacketService; NestJS; PostgreSQL; Prisma ORM; IrrigationService; Open-Meteo; Weather API; cache; Farmer dashboard; Historical data; Legend:; Hardware; Field hardware; Backend; Server logic; Database; Frontend

humidity, battery, RSSI

HTTP POST
/api/big-packet

Operations (atomic transaction):
• Router clock calibration
• OTA sync (device shadowing)
• Update router and node state
• Insert historical measurements
• Recalculate parcel average humidity
• Downlink response (configs + clock)

Measurements,
node & router state

Reads avgHumidity
and agronomic params

FAO-56 algorithm steps:
• Read parcel avgHumidity
• Fetch ET0 and rainfall (Open-Meteo)
• ETc = ET0 × Kc
• WaterNeed = Deficit + ETc − Rainfall
• Apply maximum irrigation depth limit
• Calculate irrigation time (minutes)
• Persist decision in TurnoRiego

hourly cron job

State, schedules
and irrigation alerts

• Parcel state and real-time humidity
• Next scheduled irrigation (minutes)
• Historical measurements
• Network diagnostics (errors, RSSI, battery)

Frontend / Web App
