Davidrp23/LoRa-Smart-Irrigation-Network/docs/ExplanationDiagrams/NetworkDiscovery_2.pdf

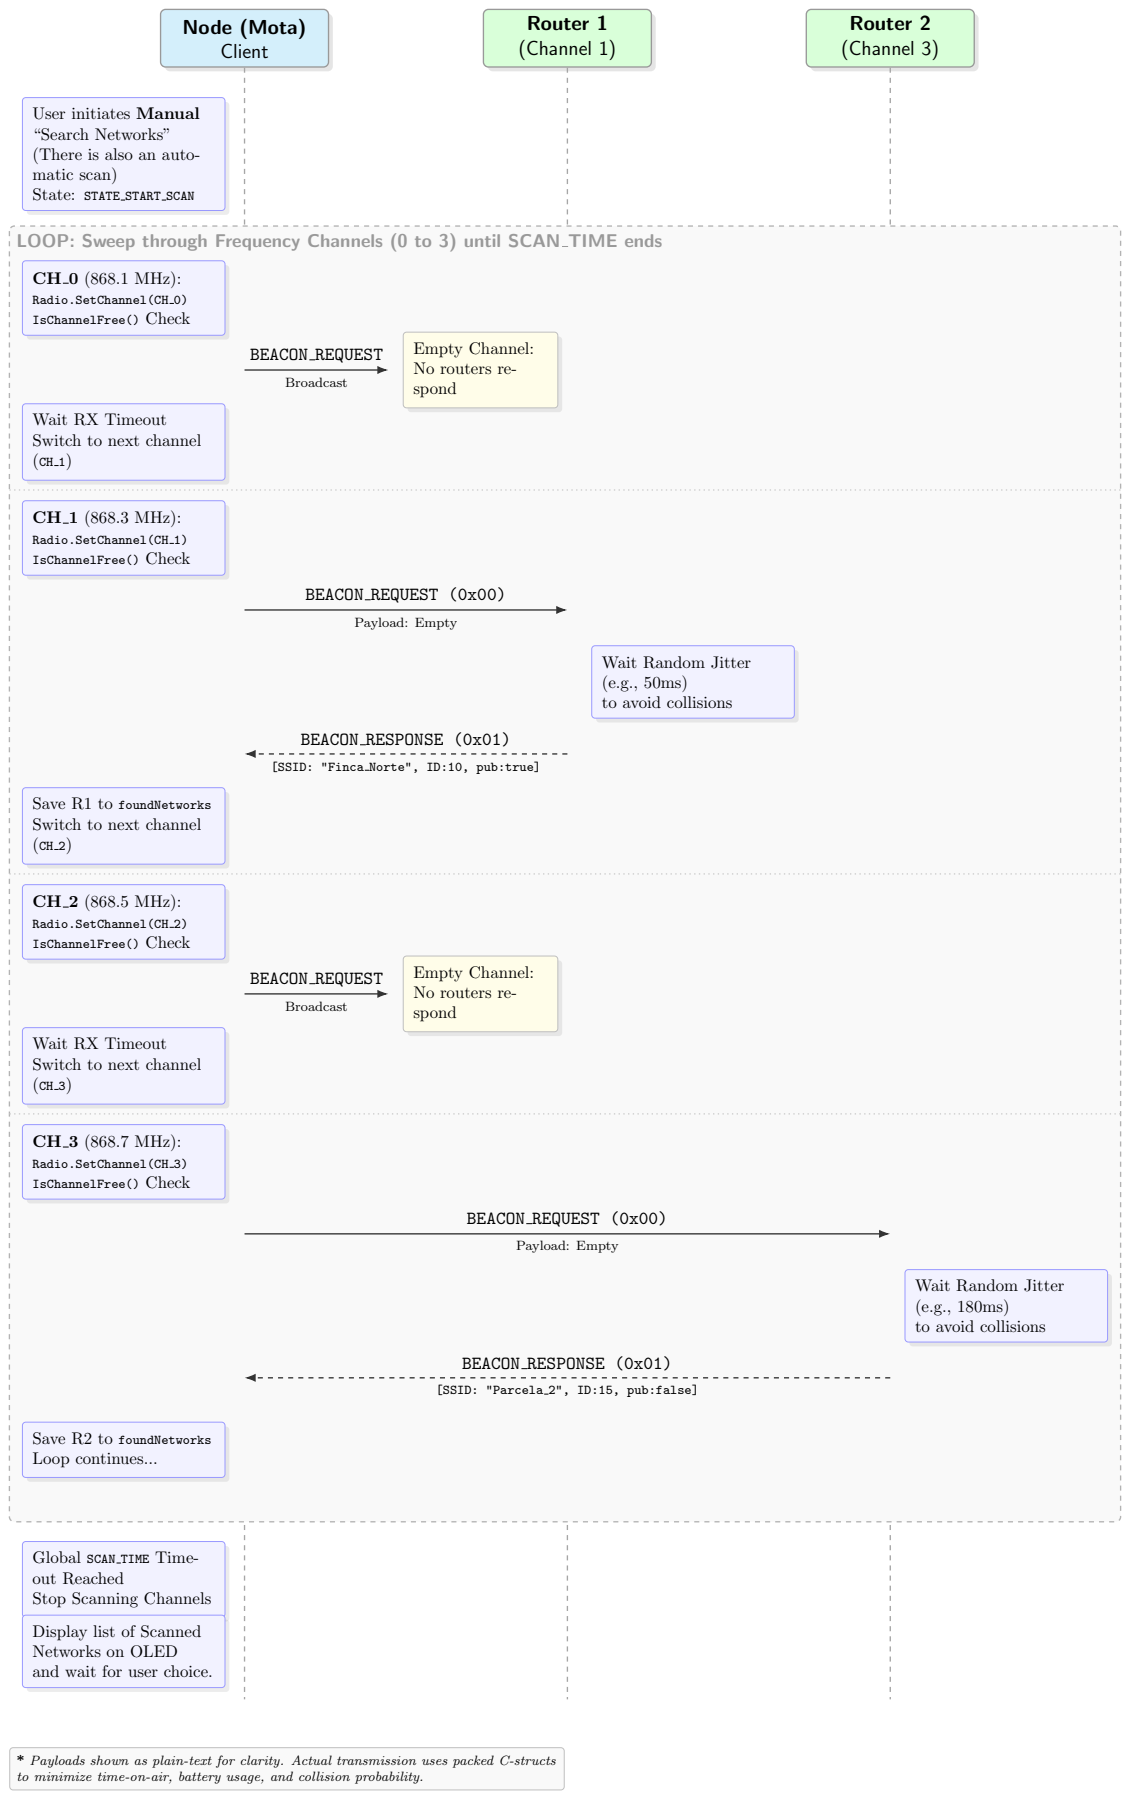
[picture p91: page 1]
Node (Mota) Client; Router 1 (Channel 1); Router 2 (Channel 3); LOOP: Sweep through Frequency Channels (0 to 3) until SCAN; TIME ends; CH 0 (868.1 MHz):; BEACON REQUEST; Broadcast; CH 1 (868.3 MHz):; BEACON REQUEST (0x00); Payload: Empty; BEACON RESPONSE (0x01); CH 2 (868.5 MHz):; CH 3 (868.7 MHz):

User initiates Manual
“Search Networks”
(There is also an auto-
matic scan)

State: STATE START SCAN

Radio.SetChannel(CH 0)
IsChannelFree() Check

Empty Channel:
No routers re-
spond

Wait RX Timeout
Switch to next channel

Radio.SetChannel(CH 1)

Wait Random Jitter
to avoid collisions

[SSID: "Finca Norte", ID:10, pub:true]

Save R1 to foundNetworks

Radio.SetChannel(CH 2)

Radio.SetChannel(CH 3)

[SSID: "Parcela 2", ID:15, pub:false]

Save R2 to foundNetworks
Loop continues...

Global SCAN TIME Time-
out Reached
Stop Scanning Channels

Display list of Scanned
Networks on OLED
and wait for user choice.

* Payloads shown as plain-text for clarity. Actual transmission uses packed C-structs
to minimize time-on-air, battery usage, and collision probability.
