Davidrp23/LoRa-Smart-Irrigation-Network/docs/ExplanationDiagrams/DbEsquema.pdf

1
*

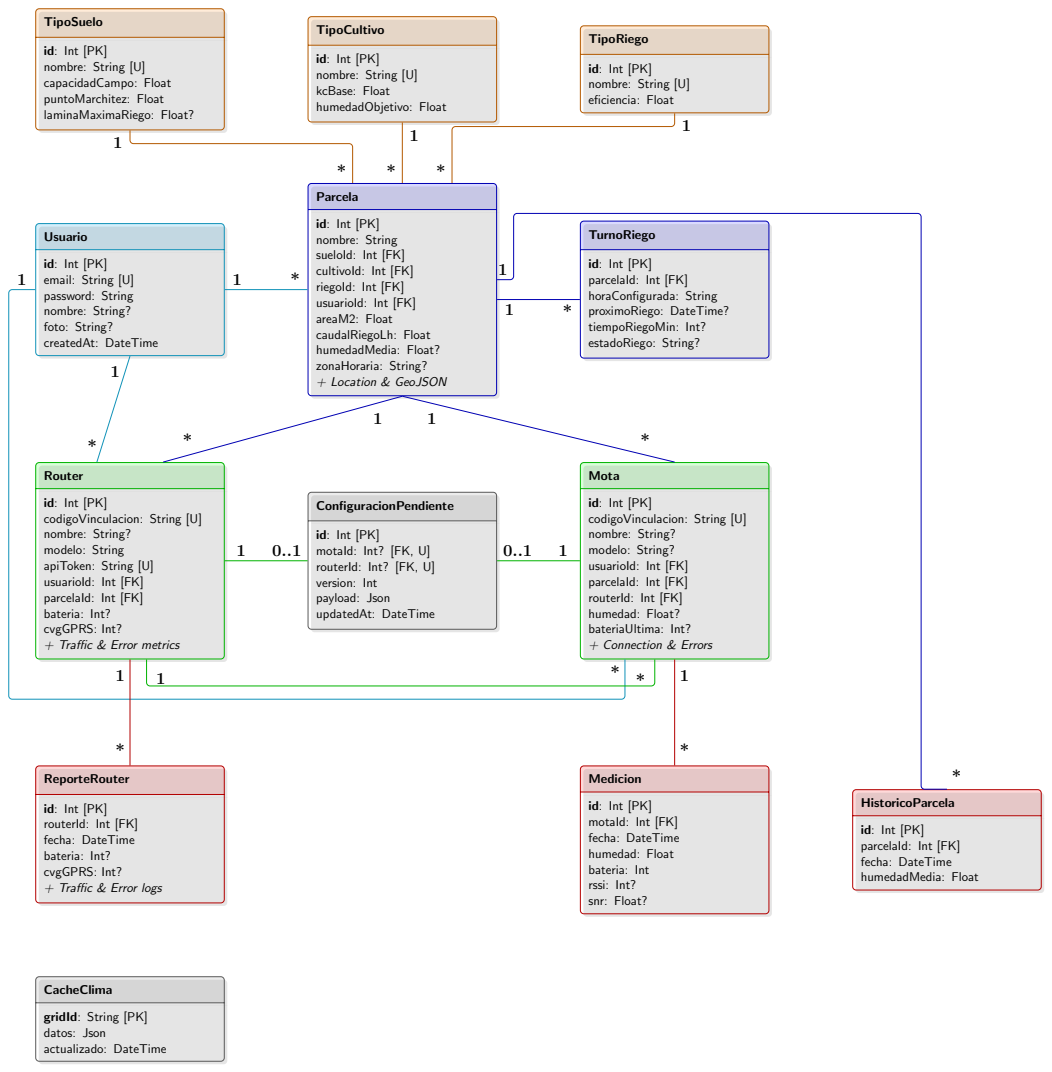
[picture p92: page 1]
TipoSuelo; TipoCultivo; TipoRiego; Usuario; Parcela; TurnoRiego; Router; ConfiguracionPendiente; Mota; ReporteRouter; Medicion; HistoricoParcela; CacheClima

id: Int [PK]
nombre: String [U]
capacidadCampo: Float
puntoMarchitez: Float
laminaMaximaRiego: Float?

kcBase: Float
humedadObjetivo: Float

eficiencia: Float

nombre: String
sueloId: Int [FK]
cultivoId: Int [FK]
riegoId: Int [FK]
usuarioId: Int [FK]
areaM2: Float
caudalRiegoLh: Float
humedadMedia: Float?
zonaHoraria: String?
+ Location & GeoJSON

email: String [U]
password: String
nombre: String?
foto: String?
createdAt: DateTime

parcelaId: Int [FK]
horaConfigurada: String
proximoRiego: DateTime?
tiempoRiegoMin: Int?
estadoRiego: String?

codigoVinculacion: String [U]
modelo: String
apiToken: String [U]
bateria: Int?
cvgGPRS: Int?
+ Traffic & Error metrics

modelo: String?
routerId: Int [FK]
humedad: Float?
bateriaUltima: Int?
+ Connection & Errors

motaId: Int? [FK, U]
routerId: Int? [FK, U]
version: Int
payload: Json
updatedAt: DateTime

motaId: Int [FK]
fecha: DateTime
humedad: Float
bateria: Int
rssi: Int?
snr: Float?

+ Traffic & Error logs

humedadMedia: Float

gridId: String [PK]
datos: Json
actualizado: DateTime
