Davidrp23/LoRa-Smart-Irrigation-Network/docs/ExplanationDiagrams/ArquitecturaGlobal.pdf

## 1. Physical Layer (Main Parcel)

## 2. Edge/Fog Layer

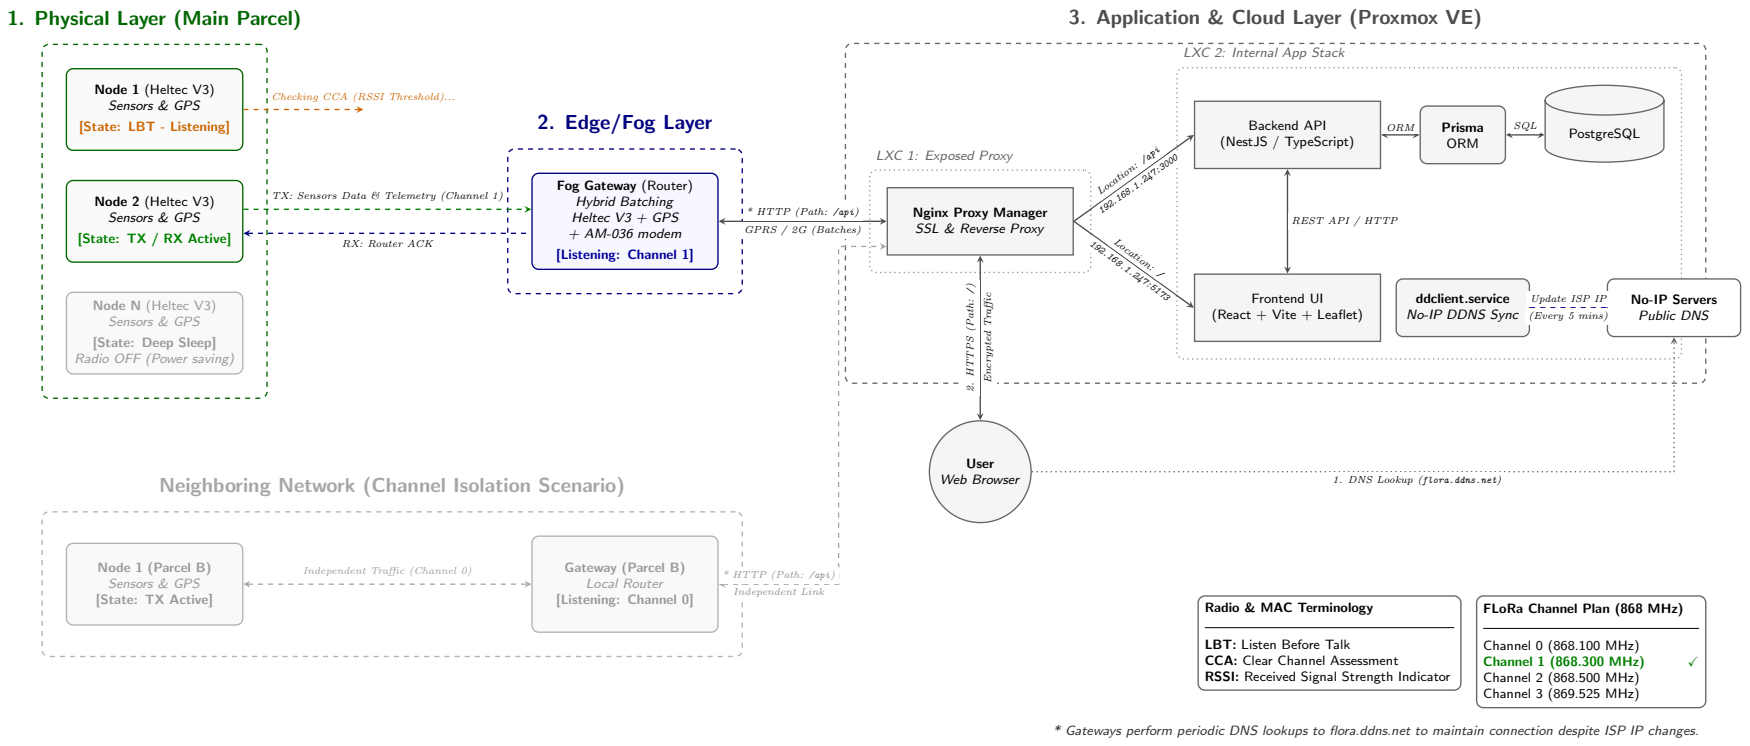
[picture p93: page 1]
Gateway (Parcel B) Local Router [Listening: Channel 0]; Backend API (NestJS / TypeScript); Frontend UI; Prisma; ORM; PostgreSQL; User Web Browser; Channel 0 (868.100 MHz); Channel 1 (868.300 MHz); Channel 2 (868.500 MHz) Channel 3 (869.525 MHz); GPRS / 2G (Batches); Independent Link; Location: /api 192.168.1.247:3000; Location: / 192.168.1.247:5173; SQL; 2. HTTPS (Path: /); Encrypted Traffic

3. Application & Cloud Layer (Proxmox VE)

LXC 2: Internal App Stack

Node 1 (Heltec V3)
Sensors & GPS
[State: LBT - Listening]

Checking CCA (RSSI Threshold)...

LXC 1: Exposed Proxy

Fog Gateway (Router)
Hybrid Batching
Heltec V3 + GPS
+ AM-036 modem
[Listening: Channel 1]

Node 2 (Heltec V3)
[State: TX / RX Active]

TX: Sensors Data & Telemetry (Channel 1)

* HTTP (Path: /api)

Nginx Proxy Manager
SSL & Reverse Proxy

REST API / HTTP

RX: Router ACK

Node N (Heltec V3)
[State: Deep Sleep]
Radio OFF (Power saving)

ddclient.service
No-IP DDNS Sync

Update ISP IP
(Every 5 mins)

No-IP Servers
Public DNS

(React + Vite + Leaflet)

1. DNS Lookup (flora.ddns.net)

Neighboring Network (Channel Isolation Scenario)

Node 1 (Parcel B)
[State: TX Active]

Independent Traffic (Channel 0)

Radio & MAC Terminology

FLoRa Channel Plan (868 MHz)

LBT: Listen Before Talk
CCA: Clear Channel Assessment
RSSI: Received Signal Strength Indicator

* Gateways perform periodic DNS lookups to flora.ddns.net to maintain connection despite ISP IP changes.
