Davidrp23/LoRa-Smart-Irrigation-Network/docs/ExplanationDiagrams/AutoFailover.pdf

### Node (Mota) Client

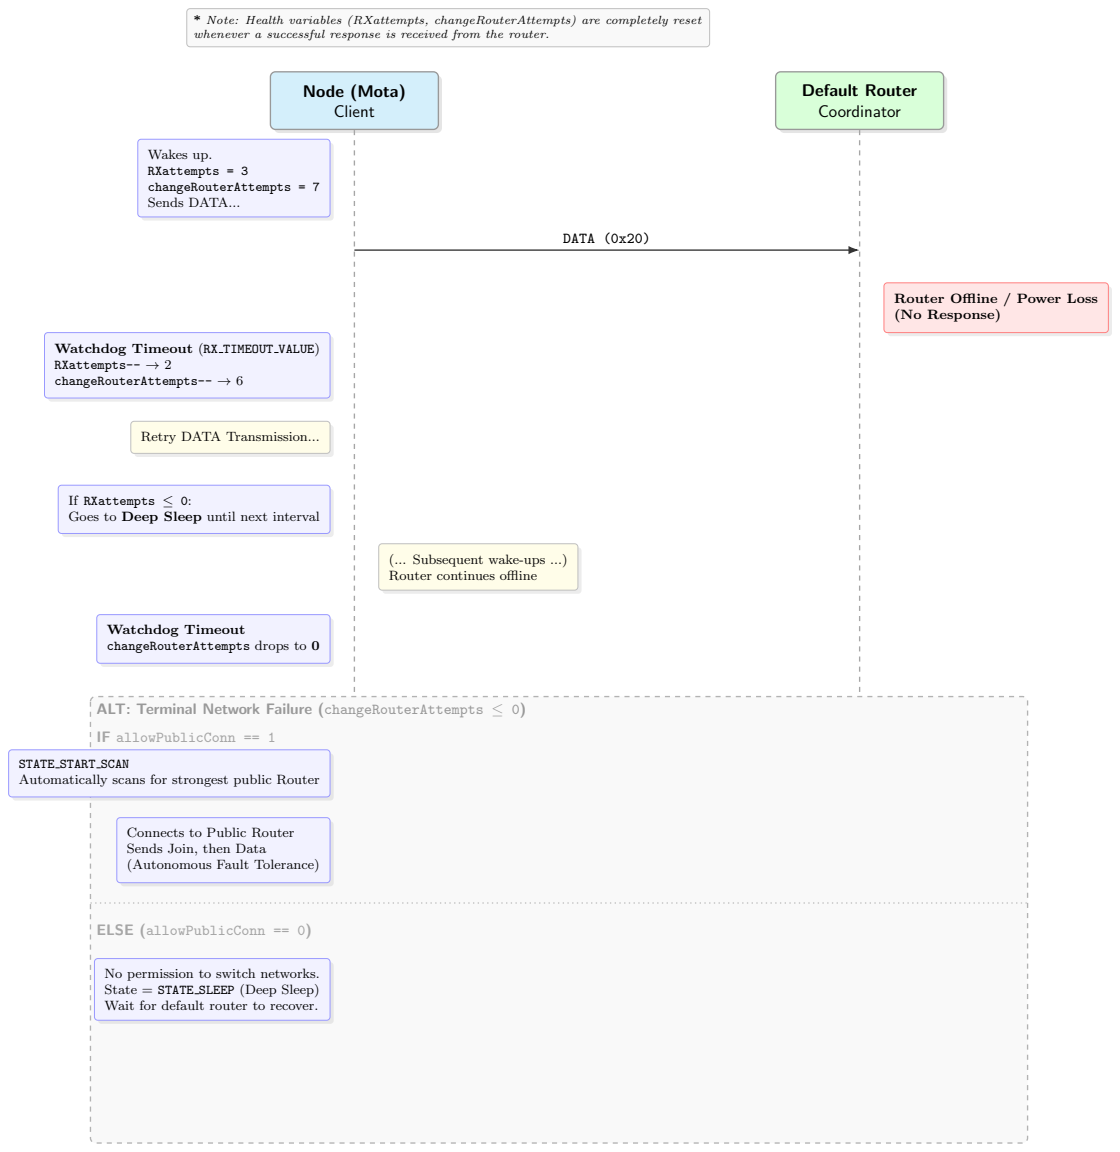
[picture p94: page 1]
Default Router Coordinator; Wakes up.; RXattempts = 3 changeRouterAttempts = 7 Sends DATA...; DATA (0x20); IF allowPublicConn == 1; ELSE (allowPublicConn == 0)

* Note: Health variables (RXattempts, changeRouterAttempts) are completely reset
whenever a successful response is received from the router.

Router Offline / Power Loss
(No Response)

Watchdog Timeout (RX TIMEOUT VALUE)
RXattempts-- → 2
changeRouterAttempts-- → 6

Retry DATA Transmission...

If RXattempts ≤ 0:
Goes to Deep Sleep until next interval

(... Subsequent wake-ups ...)
Router continues offline

Watchdog Timeout
changeRouterAttempts drops to 0

ALT: Terminal Network Failure (changeRouterAttempts ≤ 0)

STATE START SCAN
Automatically scans for strongest public Router

Connects to Public Router
Sends Join, then Data
(Autonomous Fault Tolerance)

No permission to switch networks.
State = STATE SLEEP (Deep Sleep)
Wait for default router to recover.
