Davidrp23/LoRa-Smart-Irrigation-Network/docs/ExplanationDiagrams/CryptoError.pdf

## Node (Mota) Client

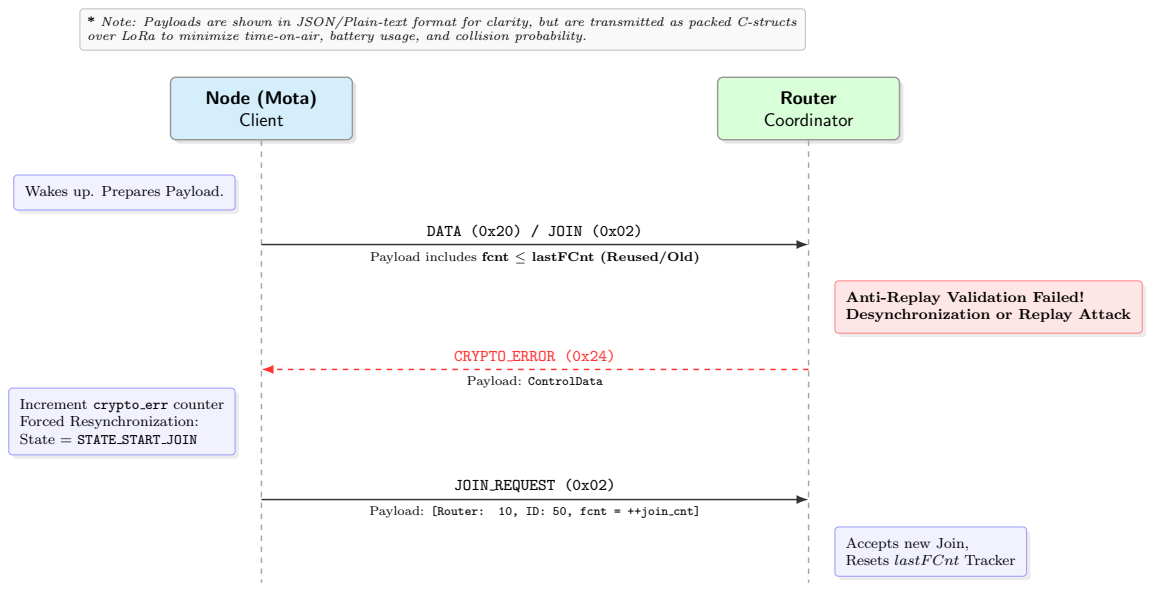
[picture p95: page 1]
Router Coordinator; DATA (0x20) / JOIN (0x02); CRYPTO ERROR (0x24); Payload: ControlData; JOIN REQUEST (0x02); Payload: [Router:; 10, ID: 50, fcnt = ++join cnt]

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

Wakes up. Prepares Payload.

Payload includes fcnt ≤ lastFCnt (Reused/Old)

Anti-Replay Validation Failed!
Desynchronization or Replay Attack

Increment crypto err counter
Forced Resynchronization:
State = STATE START JOIN

Accepts new Join,
Resets lastF Cnt Tracker
