Davidrp23/LoRa-Smart-Irrigation-Network/docs/ExplanationDiagrams/NetworkJoin.pdf

## Node (Mota) Client

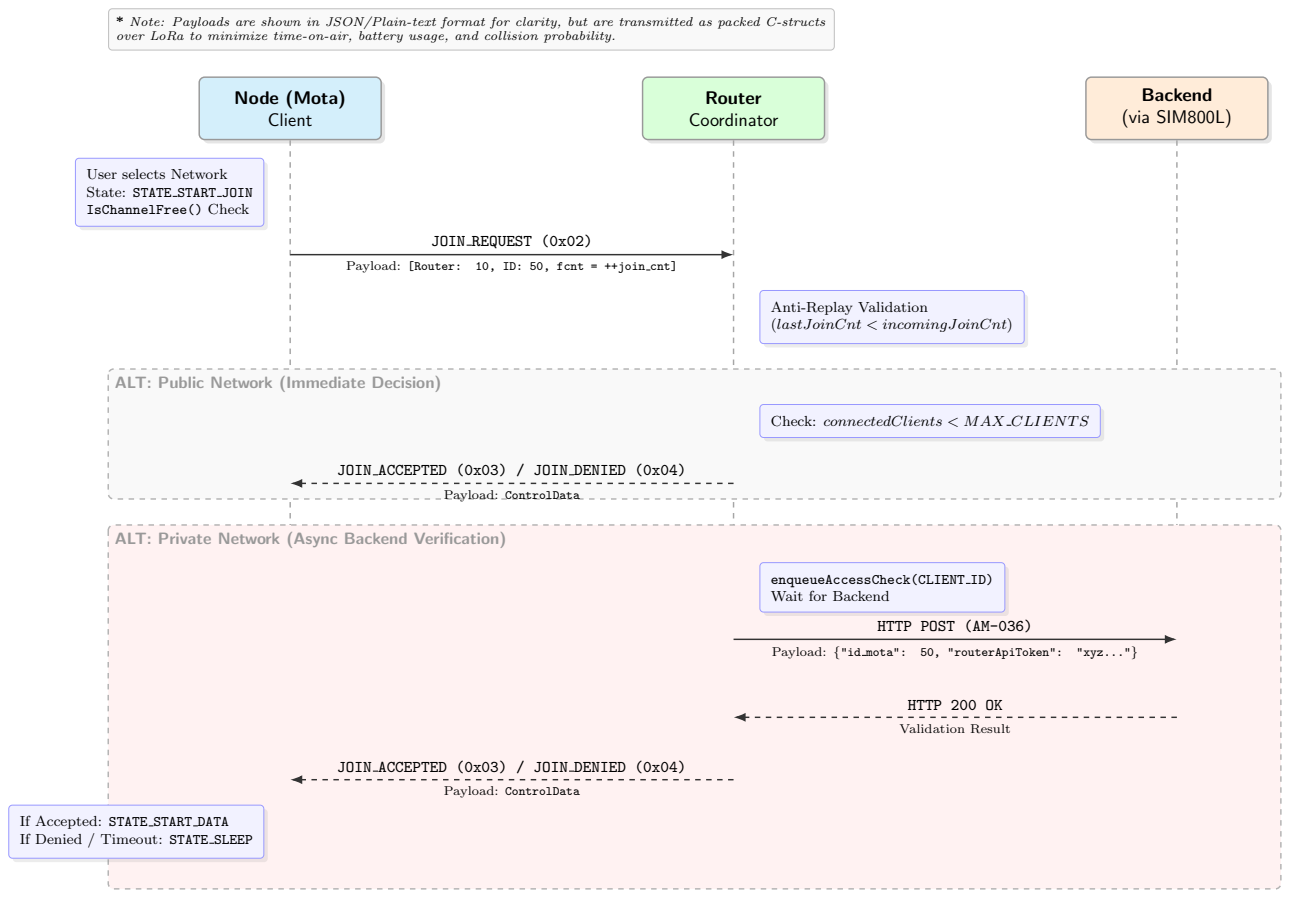
[picture p96: page 1]
Router Coordinator; Backend (via SIM800L); JOIN REQUEST (0x02); Payload: [Router:; 10, ID: 50, fcnt = ++join cnt]; Payload: ControlData; Payload: {"id mota":; 50, "routerApiToken":; "xyz..."}; HTTP 200 OK; Validation Result

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

User selects Network
State: STATE START JOIN
IsChannelFree() Check

Anti-Replay Validation
(lastJoinCnt < incomingJoinCnt)

ALT: Public Network (Immediate Decision)

Check: connectedClients < MAX CLIENT S

JOIN ACCEPTED (0x03) / JOIN DENIED (0x04)

ALT: Private Network (Async Backend Verification)

enqueueAccessCheck(CLIENT ID)
Wait for Backend

HTTP POST (AM-036)

If Accepted: STATE START DATA
If Denied / Timeout: STATE SLEEP
