Davidrp23/LoRa-Smart-Irrigation-Network/docs/ExplanationDiagrams/NodeLeaving.pdf

## Node (Mota) Client

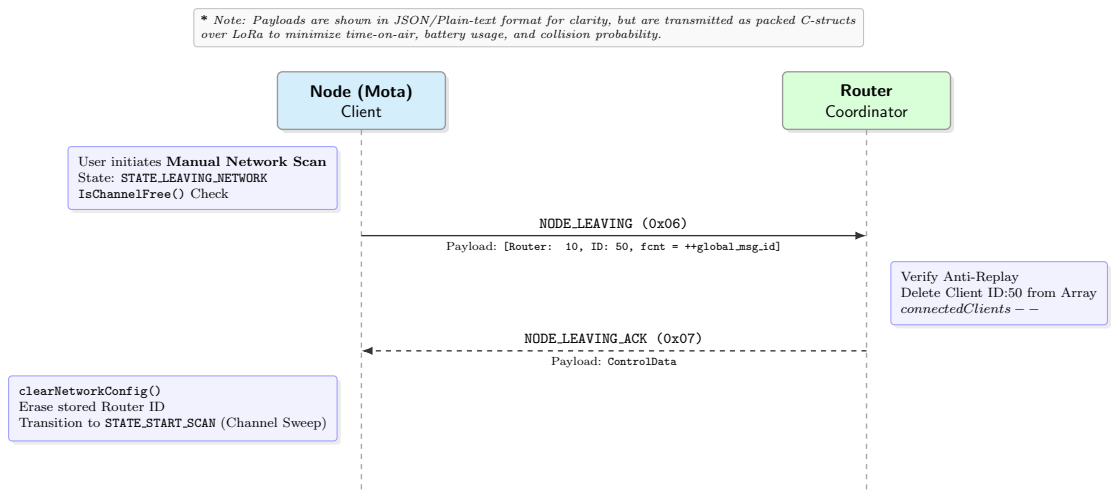
[picture p97: page 1]
Router Coordinator; NODE LEAVING (0x06); Payload: [Router:; 10, ID: 50, fcnt = ++global msg id]; Payload: ControlData

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

User initiates Manual Network Scan
State: STATE LEAVING NETWORK
IsChannelFree() Check

Verify Anti-Replay
Delete Client ID:50 from Array
connectedClients − −

NODE LEAVING ACK (0x07)

clearNetworkConfig()
Erase stored Router ID
Transition to STATE START SCAN (Channel Sweep)
