Davidrp23/LoRa-Smart-Irrigation-Network/docs/ExplanationDiagrams/TopologiaEstrella.pdf

M1

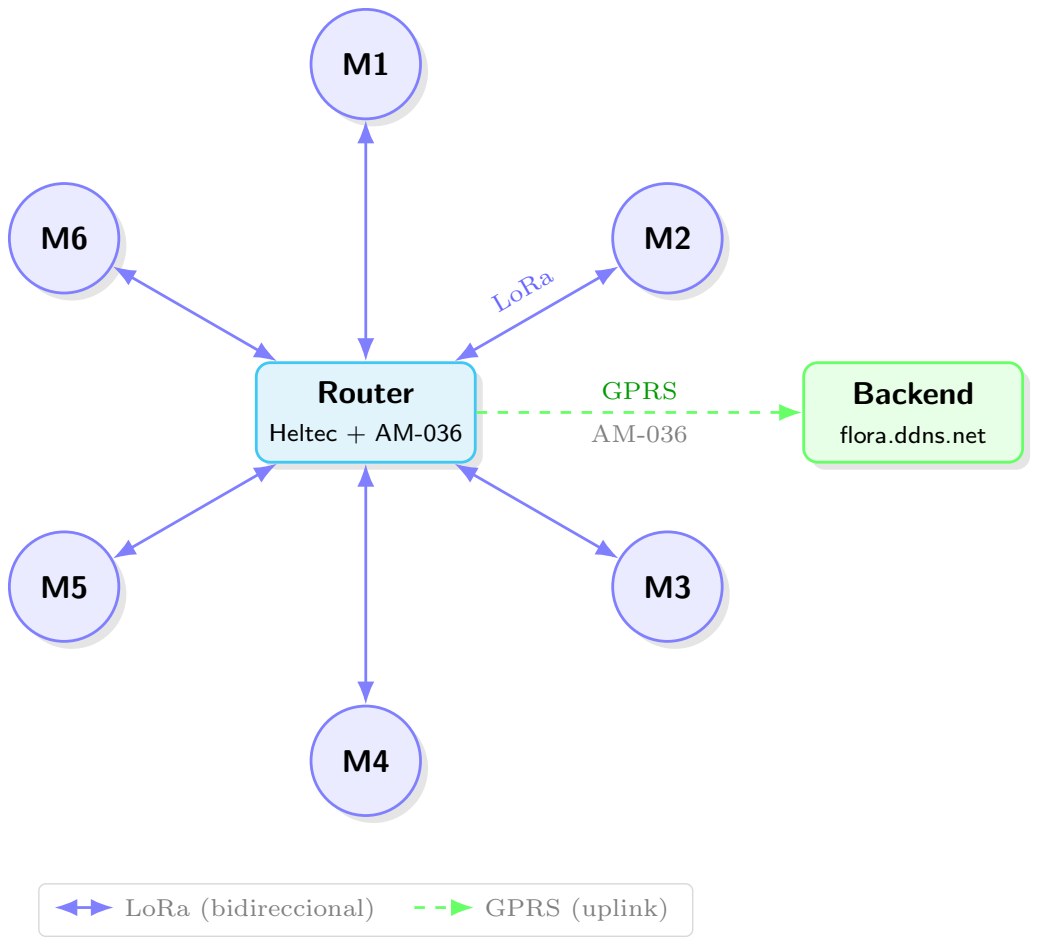
[picture p98: page 1]
Router; Heltec + AM-036; LoRa; Backend; GPRS; LoRa (bidireccional); GPRS (uplink)

flora.ddns.net
