Davidrp23/LoRa-Smart-Irrigation-Network/firmware/Router/AMcontrol.cpp

#include "display.h"
// AMcontrol.cpp
// Implementación de la tarea de control del AM-036 con arquitectura de Job
// Processor.
//
// Arquitectura:
//   - am_manager_task espera bloqueada en xTaskNotifyWait()
//   - Se auto-despierta periódicamente para evaluar si debe enviar un
//   BIG_PACKET.
//   - Puede ser despertada instantáneamente (AM_NOTIFY_NEW_JOB) si hay un
//   trabajo urgente.
//   - Al despertar, si hay trabajos en cola (o toca big packet), enciende el
//   AM,
//     procesa TODOS los trabajos pendientes uno a uno, y luego se apaga.
//   - La tarea accessCheckResponseTask procesa asíncronamente las respuestas de
//   ACCESS_CHECK.

#include "AMcontrol.h"
#include "config.h"
#include "network.h" // shared_queueSize, MAX_CLIENTS, motasDataQueue, etc.
#include "rtc_sync.h"
#include <ArduinoJson.h>
#include <algorithm> // std::remove_if

// ---------------------------------------------------------------------------
// Definición de la instancia única del driver
// ---------------------------------------------------------------------------
SerialAM am036(Serial1, AM_MOSFET_PIN);

// Cola de trabajos (entrada para am_manager_task)
QueueHandle_t amJobQueue;

// Cola de resultados (salida hacia lora_router)
QueueHandle_t amResultQueue;

// ---------------------------------------------------------------------------
// Constantes de tiempo
// ---------------------------------------------------------------------------
static constexpr uint32_t FIVE_MINUTES_MS  =  300000UL;
static constexpr uint32_t TEN_MINUTES_MS   =  600000UL;
static constexpr uint32_t TWELVE_HOURS_MS  = 43200000UL;
static constexpr uint32_t ONE_HOUR_MS      =  3600000UL;

// pdMS_TO_TICKS hace la conversión multiplicando: (ms * Hz) / 1000.
// Con valores grandes (p.ej. 12 h = 43 200 000 ms) esa multiplicación
// desborda uint32 (43200000 * 1000 > 4294967295), produciendo un umbral
// incorrecto (~250 s en lugar de 12 h).
// Solución: calcular los ticks con DIVISIÓN (ms / portTICK_PERIOD_MS),
// que nunca desborda porque portTICK_PERIOD_MS >= 1.
static constexpr TickType_t TWELVE_HOURS_TICKS = TWELVE_HOURS_MS / portTICK_PERIOD_MS;
static constexpr TickType_t ONE_HOUR_TICKS     = ONE_HOUR_MS     / portTICK_PERIOD_MS;

// Comprobación en compilación: si el tick rate fuera tan bajo que
// portTICK_PERIOD_MS > FIVE_MINUTES_MS habría pérdida de resolución.
static_assert(portTICK_PERIOD_MS <= 1000,
  "portTICK_PERIOD_MS demasiado grande: revisar configTICK_RATE_HZ");

// Timeout máximo esperando READY o SEND_DONE para un *único* job
static constexpr uint32_t JOB_TIMEOUT_MS =
    300000UL; // 5 min — margen real para GPRS

// Estructura interna para encolar trabajos
struct InternalAMJob {
  AMJobType type;
  size_t nodeId; // Usado para ACCESS_CHECK
};

// ---------------------------------------------------------------------------
// Construcción del BigPacket
//
// Formato JSON compacto para ahorrar flujo en transmisión por datos móviles:
//
// rt (router telemetry):
//   b  = batería (placeholder fijo 100% hasta integrar sensor)
//   lt = latitud
//   lg = longitud
//   tx = paquetes transmitidos
//   rx = paquetes recibidos
//   eT = errores TX
//   eR = errores RX
//   eC = errores criptográficos
//   qF = desbordamientos de cola
//   cB = errores canal ocupado
//   cv = cobertura GPRS (CSQ)
//   v  = versión configuración router
//
// ms (motas / sensores) — array:
//   id = ID de la mota
//   lt = latitud
//   lg = longitud
//   b  = batería (%)
//   h  = humedad (%)
//   rs = RSSI último paquete
//   sn = SNR último paquete (se calcula como ratio TX/RX simplificado)
//   eR = errores RX de la mota
//   v  = versión configuración mota
// ---------------------------------------------------------------------------
static String buildBigPacket() {
  // --- 1. Copiar datos compartidos bajo mutex (sección crítica breve) ---
  size_t local_tx = 0, local_rx = 0;
  size_t local_tx_err = 0, local_rx_err = 0;
  size_t local_queueFull = 0, local_crypto_err = 0, local_crc_err = 0;
  uint16_t local_channelBusy = 0;
  uint16_t local_version = 0;
  int8_t local_coverage = 0;
  std::vector<TimestampedSensorsData> localMotas;

  if (xSemaphoreTake(statsMutex, pdMS_TO_TICKS(100)) == pdTRUE) {
    local_tx = shared_tx;
    local_rx = shared_rx;
    local_tx_err = shared_tx_err;
    local_rx_err = shared_rx_err;
    local_queueFull = shared_queueFull;
    local_channelBusy = shared_channelBusyErrors;
    local_crypto_err = shared_crypto_err;
    local_crc_err = shared_crc_err;
    local_version = version;
    local_coverage = shared_coverage;
    // Mark-and-copy: marcamos los elementos que se van a enviar y los copiamos.
    // Si llegan datos nuevos durante la transmisión AM, tendrán markedForSend =
    // false y sobrevivirán al borrado posterior.
    localMotas.reserve(motasDataQueue.size());
    for (auto &entry : motasDataQueue) {
      entry.markedForSend = true;
      localMotas.push_back(entry);
    }
    xSemaphoreGive(statsMutex);
  } else {
    Serial.println(
        F("[AM_CTRL] No se pudo tomar statsMutex para buildBigPacket."));
    return "{}";
  }

  // GPS y batería del router (segunda toma breve e independiente)
  double local_lat = 0.0;
  double local_lon = 0.0;
  float local_batPct = -1.0f; // -1 = sin datos
  if (xSemaphoreTake(statsMutex, pdMS_TO_TICKS(50)) == pdTRUE) {
    local_lat = shared_gps.latitude;
    local_lon = shared_gps.longitude;
    if (shared_battery.isValid)
      local_batPct = shared_battery.percentage;
    xSemaphoreGive(statsMutex);
  }

  // --- 2. Construir JSON sobre las copias locales (sin mutex) ---
  JsonDocument doc;

  // Router telemetry
  JsonObject rt = doc["rt"].to<JsonObject>();
  rt["b"] = (local_batPct >= 0.0f) ? (int)local_batPct
                                   : -1; // -1 = fuel gauge no disponible
  rt["lt"] = local_lat;
  rt["lg"] = local_lon;
  rt["tx"] = (unsigned long)local_tx;
  rt["rx"] = (unsigned long)local_rx;
  rt["eT"] = (unsigned long)local_tx_err;
  rt["eR"] = (unsigned long)local_rx_err;
  rt["eCry"] = (unsigned long)local_crypto_err;
  rt["eCrc"] = (unsigned long)local_crc_err;
  rt["qF"] = (unsigned long)local_queueFull;
  rt["cB"] = local_channelBusy;
  rt["cv"] = local_coverage;
  rt["v"] = local_version;

  // Timestamp del reloj interno del router (para que el backend detecte
  // desfase)
  uint32_t routerTime = rtcSyncNow();
  if (routerTime > 0) {
    rt["t"] = routerTime;
  }

  // Motas array
  JsonArray ms = doc["ms"].to<JsonArray>();
  for (size_t i = 0; i < localMotas.size(); i++) {
    JsonObject m = ms.add<JsonObject>();
    m["id"] = (unsigned long)localMotas[i].data.id;
    m["lt"] = localMotas[i].data.latitude;
    m["lg"] = localMotas[i].data.longitude;
    m["b"] = localMotas[i].data.battery;
    m["h"] = localMotas[i].data.humidity;
    m["rs"] = localMotas[i].data.lastRssi;
    m["sn"] = localMotas[i].data.lastSnr;
    m["tx"] = localMotas[i].data.sendedPackets;
    m["rx"] = localMotas[i].data.receivedPackets;
    m["eR"] = localMotas[i].data.rx_err;
    m["eT"] = localMotas[i].data.tx_err;
    m["cB"] = localMotas[i].data.channelBusyErrors;
    m["eCry"] = localMotas[i].data.crypto_err;
    m["mA"] = localMotas[i].data.missingAckErrors;
    m["eCrc"] = localMotas[i].data.crc_err;
    m["v"] = localMotas[i].data.version;
    // Timestamp de recepción: solo lo incluimos si el reloj estaba calibrado (>
    // 0)
    if (localMotas[i].timestamp > 0) {
      m["t"] = localMotas[i].timestamp;
    }
  }

  String out;
  serializeJson(doc, out);
  return out;
}

// ---------------------------------------------------------------------------
// Condiciones de envío del BigPacket
// ---------------------------------------------------------------------------
// Versión extendida que además rellena las sub-condiciones para diagnóstico
struct BigPacketConditions {
  bool oldPacket;  // ≥ 1h desde primer paquete pendiente
  bool queueFull;  // Cola llena (MAX_CLIENTS)
  bool heartbeat;  // Sin envío en ≥ 12 h
  bool triggered;  // = oldPacket || queueFull || heartbeat
  // Valores auxiliares para el log
  TickType_t firstPktTs;
  uint8_t    queueSz;
  TickType_t ageTicks;      // xTaskGetTickCount() - firstPktTs
  TickType_t sinceLastSend; // xTaskGetTickCount() - lastSendTs
};

static BigPacketConditions evalBigPacketConditions(TickType_t lastSendTs) {
  BigPacketConditions c{};

  if (xSemaphoreTake(statsMutex, (TickType_t)10) == pdTRUE) {
    c.firstPktTs = shared_firstPktTimestamp;
    c.queueSz    = shared_queueSize;
    xSemaphoreGive(statsMutex);
  }

  TickType_t now = xTaskGetTickCount();

  // Condición 1: ≥ 1 hora desde que llegó el primer paquete pendiente
  // Usamos ONE_HOUR_TICKS (calculado por división) para evitar overflow.
  c.ageTicks  = (c.firstPktTs > 0) ? (now - c.firstPktTs) : 0;
  c.oldPacket = (c.firstPktTs > 0) &&
                (c.ageTicks >= ONE_HOUR_TICKS);

  // Condición 2: cola llena (máximo de clientes alcanzado)
  c.queueFull = (c.queueSz >= MAX_CLIENTS);

  // Condición 3: no se envió nada en las últimas 12 horas (telemetría router)
  // IMPORTANTE: pdMS_TO_TICKS(43200000) desborda uint32 con Hz=1000.
  // Usamos TWELVE_HOURS_TICKS (calculado por división) en su lugar.
  c.sinceLastSend = (lastSendTs > 0) ? (now - lastSendTs) : 0;
  c.heartbeat = (lastSendTs == 0) ||
                (c.sinceLastSend >= TWELVE_HOURS_TICKS);

  c.triggered = c.oldPacket || c.queueFull || c.heartbeat;
  return c;
}

static bool checkBigPacketConditions(TickType_t lastSendTs) {
  return evalBigPacketConditions(lastSendTs).triggered;
}

// ---------------------------------------------------------------------------
// Tarea procesadora de trabajos (reemplaza a uplink_manager_task)
// ---------------------------------------------------------------------------
TaskHandle_t amManagerTaskHandle = nullptr;

static void am_manager_task(void *pvParameters) {
  (void)pvParameters;

  TickType_t lastBigPacketSendTs =
      0; // timestamp del último envío exitoso de BP

  bool manualBpRequested = false;

  for (;;) {
    bool hasJobs = (uxQueueMessagesWaiting(amJobQueue) > 0);
    bool timeForBigPacket = checkBigPacketConditions(lastBigPacketSendTs);

    if (!hasJobs && !timeForBigPacket && !manualBpRequested) {
      // Nada que hacer: bloqueamos hasta 10 mins o hasta que nos despierten
      // (AM_NOTIFY_NEW_JOB o AM_NOTIFY_MANUAL_BP)
      uint32_t notif = 0;
      xTaskNotifyWait(0, 0xFFFFFFFF, &notif, pdMS_TO_TICKS(TEN_MINUTES_MS));
      if (notif & AM_NOTIFY_MANUAL_BP) {
        manualBpRequested = true;
        Serial.println(F("[AM_CTRL] Big-packet manual solicitado desde OLED."));
      } else if (!(notif & AM_NOTIFY_NEW_JOB)) {
        // Despertado por timeout pero sin condiciones: volver a esperar
        continue;
      }
    }

    // ---- DIAGNÓSTICO: motivo del encendido del AM -------------------------
    {
      BigPacketConditions bp = evalBigPacketConditions(lastBigPacketSendTs);

      Serial.println(F("\n[AM_CTRL] ======= ENCENDIENDO AM — DIAGNÓSTICO ======="));

      // Estado de cada condición
      Serial.printf("[AM_CTRL]   hasJobs          : %s\n",
                    hasJobs ? "SI" : "NO");
      Serial.printf("[AM_CTRL]   manualBpRequested: %s\n",
                    manualBpRequested ? "SI" : "NO");
      Serial.println(F("[AM_CTRL]   --- Condiciones BigPacket ---"));
      Serial.printf("[AM_CTRL]   [C1] oldPacket (>=1h desde 1er pkt): %s"
                    "  (firstPktTs=%lu  edad=%lu ms  umbral=%lu ms)\n",
                    bp.oldPacket ? "SI" : "NO",
                    (unsigned long)bp.firstPktTs,
                    (unsigned long)pdTICKS_TO_MS(bp.ageTicks),
                    (unsigned long)ONE_HOUR_MS);
      Serial.printf("[AM_CTRL]   [C2] queueFull  (cola >= MAX):       %s"
                    "  (queueSz=%u  MAX_CLIENTS=%u)\n",
                    bp.queueFull ? "SI" : "NO",
                    (unsigned)bp.queueSz,
                    (unsigned)MAX_CLIENTS);
      Serial.printf("[AM_CTRL]   [C3] heartbeat  (>=12h sin envio):   %s"
                    "  (sinceLastSend=%lu ms  umbral=%lu ms)\n",
                    bp.heartbeat ? "SI" : "NO",
                    (unsigned long)pdTICKS_TO_MS(bp.sinceLastSend),
                    (unsigned long)TWELVE_HOURS_MS);

      // Causa(s) que dispararon el encendido
      Serial.print(F("[AM_CTRL]   CAUSA(S): "));
      bool primero = true;
      if (hasJobs)          { Serial.print(F("JOBS_PENDIENTES"));  primero = false; }
      if (manualBpRequested){ if (!primero) Serial.print(F(", ")); Serial.print(F("MANUAL_BP")); primero = false; }
      if (bp.oldPacket)     { if (!primero) Serial.print(F(", ")); Serial.print(F("C1_PAQUETE_ANTIGUO")); primero = false; }
      if (bp.queueFull)     { if (!primero) Serial.print(F(", ")); Serial.print(F("C2_COLA_LLENA")); primero = false; }
      if (bp.heartbeat)     { if (!primero) Serial.print(F(", ")); Serial.print(F("C3_HEARTBEAT_12H")); primero = false; }
      if (primero)           Serial.print(F("(desconocida)"));
      Serial.println();
      Serial.println(F("[AM_CTRL] ================================================\n"));
    }
    // -----------------------------------------------------------------------

    // 1. Encendemos el módulo
    am036.powerOn();

    // 2. Esperamos READY (con timeout de JOB_TIMEOUT_MS)
    bool moduleReady = false;
    uint32_t notif = 0;
    TickType_t waitStart = xTaskGetTickCount();

    while (!moduleReady) {
      if (xTaskGetTickCount() - waitStart >= pdMS_TO_TICKS(JOB_TIMEOUT_MS)) {
        Serial.println(F("[AM_CTRL] Timeout esperando READY del AM-036."));
        break;
      }

      BaseType_t got =
          xTaskNotifyWait(0, 0xFFFFFFFF, &notif, pdMS_TO_TICKS(100));
      am036.update();

      if (got == pdTRUE) {
        if (notif & AM_NOTIFY_ERROR) {
          Serial.println(F("[AM_CTRL] Error de red reportado por módulo."));
          break;
        }
        if (notif & AM_NOTIFY_READY) {
          if (xSemaphoreTake(statsMutex, (TickType_t)10) == pdTRUE) {
            shared_coverage = am036.getLastCsq();
            xSemaphoreGive(statsMutex);
          }
          moduleReady = true;
          Serial.println(F("[AM_CTRL] AM-036 READY."));
        }
      }
    }

    if (!moduleReady) {
      am036.powerOff();

      // Si no pudo encender, debemos vaciar la cola de jobs y marcarlos como
      // FALLIDOS (fail-safe) para no dejar colgado al sistema.
      InternalAMJob job;
      while (xQueueReceive(amJobQueue, &job, 0) == pdTRUE) {
        if (job.type == AMJobType::ACCESS_CHECK) {
          AMJobResult result = {AMJobType::ACCESS_CHECK, false, 0, "",
                                job.nodeId};
          xQueueSend(amResultQueue, &result, 0);
        }
      }

      // Penalización de 10 minutos: evitamos un bucle agresivo si el módulo
      // tiene un problema persistente (sin cobertura, fallo hardware, etc.).
      // Solo un encendido manual desde la OLED (AM_NOTIFY_MANUAL_BP) puede
      // romper la espera anticipadamente. Cualquier otra notificación
      // (NEW_JOB, etc.) se consume y se vuelve a dormir por el tiempo restante;
      // los jobs están seguros en amJobQueue y se procesarán tras la
      // penalización.
      Serial.println(F("[AM_CTRL] Módulo no listo. Penalización de 10 minutos "
                       "(solo encendido manual desde OLED la interrumpe)."));

      manualBpRequested = false;
      TickType_t penaltyStart = xTaskGetTickCount();

      while ((xTaskGetTickCount() - penaltyStart) <
             pdMS_TO_TICKS(TEN_MINUTES_MS)) {
        TickType_t elapsed = xTaskGetTickCount() - penaltyStart;
        TickType_t remaining = pdMS_TO_TICKS(TEN_MINUTES_MS) - elapsed;

        uint32_t wakeReason = 0;
        xTaskNotifyWait(0, 0xFFFFFFFF, &wakeReason, remaining);

        if (wakeReason & AM_NOTIFY_MANUAL_BP) {
          Serial.println(F("[AM_CTRL] Encendido manual solicitado. "
                           "Saltando penalización."));
          manualBpRequested = true;
          break;
        }
        // Cualquier otra causa (NEW_JOB, timeout parcial): ignorar y
        // volver a dormir por el tiempo restante.
      }

      if (!manualBpRequested) {
        Serial.println(F("[AM_CTRL] Penalización completada. Reintentando."));
      }
      continue;
    }

    // 3. Procesamos BIG_PACKET si toca o si se solicitó manualmente
    if (timeForBigPacket || manualBpRequested) {
      Serial.println(F("[AM_CTRL] Ejecutando Job: BIG_PACKET"));
      String payload = buildBigPacket();
      if (am036.sendBigPacket(payload)) {

        // Esperamos resultado
        bool jobDone = false;
        waitStart = xTaskGetTickCount();
        while (!jobDone) {
          if (xTaskGetTickCount() - waitStart >= pdMS_TO_TICKS(JOB_TIMEOUT_MS))
            break;

          BaseType_t got =
              xTaskNotifyWait(0, 0xFFFFFFFF, &notif, pdMS_TO_TICKS(100));
          am036.update();

          if (got == pdTRUE) {
            if (notif & AM_NOTIFY_SEND_OK) {
              AMSendResult res = am036.getLastResult();
              Serial.printf("[AM_CTRL] BIG_PACKET OK (HTTP %d).\n",
                            res.httpCode);
              parseBigPacketResponse(res.responseBody);

              if (xSemaphoreTake(statsMutex, pdMS_TO_TICKS(100)) == pdTRUE) {
                // Mark-and-sweep: eliminamos solo los datos que se marcaron
                // antes del envío. Los que llegaron durante la transmisión AM
                // (markedForSend == false) se conservan en la cola.
                motasDataQueue.erase(
                    std::remove_if(motasDataQueue.begin(), motasDataQueue.end(),
                                   [](const TimestampedSensorsData &e) {
                                     return e.markedForSend;
                                   }),
                    motasDataQueue.end());
                shared_queueSize = motasDataQueue.size();
                // Solo reseteamos el timestamp si la cola quedó vacía
                if (motasDataQueue.empty()) {
                  shared_firstPktTimestamp = 0;
                }
                xSemaphoreGive(statsMutex);
              }
              lastBigPacketSendTs = xTaskGetTickCount();
              jobDone = true;
            } else if (notif & AM_NOTIFY_SEND_FAIL) {
              AMSendResult res = am036.getLastResult();
              Serial.printf("[AM_CTRL] BIG_PACKET FALLÓ (HTTP %d).\n",
                            res.httpCode);
              jobDone = true; // Terminamos el intento
            } else if (notif & AM_NOTIFY_ERROR) {
              Serial.println(
                  F("[AM_CTRL] Error de red crítico durante BIG_PACKET."));
              break; // Rompemos el while interno
            }
          }
        }
      }
    }

    // 4. Procesamos todos los jobs pendientes en la cola (por ahora solo
    // ACCESS_CHECK)
    InternalAMJob currentJob;
    while (xQueueReceive(amJobQueue, &currentJob, 0) == pdTRUE) {
      if (currentJob.type == AMJobType::ACCESS_CHECK) {
        Serial.printf("[AM_CTRL] Ejecutando Job: ACCESS_CHECK para nodo %zu\n",
                      currentJob.nodeId);

        String path = "/api/routers/permitirAcceso/";
        path += String(currentJob.nodeId);

        if (am036.sendGetRequest(path)) {
          bool jobDone = false;
          waitStart = xTaskGetTickCount();

          AMJobResult res = {AMJobType::ACCESS_CHECK, false, 0, "",
                             currentJob.nodeId};

          while (!jobDone) {
            if (xTaskGetTickCount() - waitStart >=
                pdMS_TO_TICKS(JOB_TIMEOUT_MS))
              break;

            BaseType_t got =
                xTaskNotifyWait(0, 0xFFFFFFFF, &notif, pdMS_TO_TICKS(100));
            am036.update();

            if (got == pdTRUE) {
              if (notif & AM_NOTIFY_SEND_OK) {
                AMSendResult r = am036.getLastResult();
                Serial.printf("[AM_CTRL] ACCESS_CHECK OK (HTTP %d).\n",
                              r.httpCode);
                res.success = true;
                res.httpCode = r.httpCode;
                res.responseBody = r.responseBody;
                jobDone = true;
              } else if (notif & AM_NOTIFY_SEND_FAIL) {
                AMSendResult r = am036.getLastResult();
                Serial.printf("[AM_CTRL] ACCESS_CHECK FALLÓ (HTTP %d).\n",
                              r.httpCode);
                res.success = false;
                res.httpCode = r.httpCode;
                res.responseBody = r.responseBody;
                jobDone = true;
              } else if (notif & AM_NOTIFY_ERROR) {
                Serial.println(
                    F("[AM_CTRL] Error crítico durante ACCESS_CHECK."));
                res.success = false;
                break;
              }
            }
          }

          // Enviamos resultado a la cola de salida para lora_router
          xQueueSend(amResultQueue, &res, 0);
        }
      }
    }

    // 5. Apagamos el módulo siempre al final del ciclo
    am036.powerOff();
    manualBpRequested = false; // Reset tras ciclo exitoso
    Serial.println(F("[AM_CTRL] Ciclo de jobs completado. Módulo apagado."));
  }
}

// ---------------------------------------------------------------------------
// Encolar trabajos de verificación
// ---------------------------------------------------------------------------
bool enqueueAccessCheck(size_t nodeId) {
  if (amJobQueue == nullptr)
    return false;

  InternalAMJob job;
  job.type = AMJobType::ACCESS_CHECK;
  job.nodeId = nodeId;

  if (xQueueSend(amJobQueue, &job, pdMS_TO_TICKS(10)) == pdTRUE) {
    // Si lo encolamos bien, despertamos a la tarea inmediatamente
    if (amManagerTaskHandle != nullptr) {
      xTaskNotify(amManagerTaskHandle, AM_NOTIFY_NEW_JOB, eSetBits);
    }
    return true;
  }
  return false;
}

// ---------------------------------------------------------------------------
// Disparo manual de big-packet desde el OLED
// ---------------------------------------------------------------------------
void triggerManualBigPacket() {
  if (amManagerTaskHandle != nullptr) {
    // eSetBits es ISR-safe y no requiere sección crítica adicional
    xTaskNotify(amManagerTaskHandle, AM_NOTIFY_MANUAL_BP, eSetBits);
    Serial.println(F("[AM_CTRL] Notificación AM_NOTIFY_MANUAL_BP enviada."));
  } else {
    Serial.println(F("[AM_CTRL] WARN: triggerManualBigPacket() llamado antes "
                     "de startUplinkTask()."));
  }
}

// ---------------------------------------------------------------------------
// Tarea para procesar asíncronamente las respuestas del AM
// ---------------------------------------------------------------------------
static void accessCheckResponseTask(void *pvParameters) {
  (void)pvParameters;
  AMJobResult result;

  for (;;) {
    // Bloqueamos hasta que haya una respuesta del AM
    if (xQueueReceive(amResultQueue, &result, portMAX_DELAY) == pdTRUE) {
      if (result.type == AMJobType::ACCESS_CHECK) {
        Serial.printf("[ACCESS_TASK] Respuesta recibida para nodo %zu: "
                      "success=%d HTTP=%d body='%s'\n",
                      result.nodeId, result.success, result.httpCode,
                      result.responseBody.c_str());

        bool accessGranted = false;

        if (result.success && result.httpCode == 200) {
          // El backend devuelve un string "true" o "false"
          if (result.responseBody == "true") {
            accessGranted = true;
          }
        }

        if (accessGranted) {
          Serial.printf("[ACCESS_TASK] Backend acepta al nodo %zu.\n",
                        result.nodeId);

          if (xSemaphoreTake(statsMutex, (TickType_t)10) == pdTRUE) {
            if (shared_connectedClients < MAX_CLIENTS) {
              shared_connectedClients++;
            }
            xSemaphoreGive(statsMutex);
          }
          addClient(result.nodeId);
          sendControlPacket(messageType::JOIN_ACCEPTED, result.nodeId);
        } else {
          Serial.printf(
              "[ACCESS_TASK] Backend deniega al nodo %zu (o falló red).\n",
              result.nodeId);
          sendControlPacket(messageType::JOIN_DENIED, result.nodeId);
        }
      }
    }
  }
}

// ---------------------------------------------------------------------------
// API pública
// ---------------------------------------------------------------------------
void AMSetup() {
  // begin() configura el MOSFET (LOW) y los pines TX/RX como INPUT
  // (alta impedancia) para no alimentar el AM-036 por corriente parásita
  am036.begin(115200, AM_RX_PIN, AM_TX_PIN);

  // Crear colas
  amJobQueue = xQueueCreate(10, sizeof(InternalAMJob));
  amResultQueue = xQueueCreate(10, sizeof(AMJobResult));

  Serial.println(F("[AM_CTRL] Setup completado. Colas creadas."));
}

void startUplinkTask() {
  xTaskCreatePinnedToCore(
      am_manager_task,      // Función
      "AmManager",          // Nombre debug
      4096,                 // Stack (words)
      nullptr,              // Sin parámetros
      2,                    // Prioridad
      &amManagerTaskHandle, // Handle → lo registramos en el driver
      0                     // Core 0
  );

  am036.setControlTask(amManagerTaskHandle);
  Serial.println(F("[AM_CTRL] Tarea AmManager creada."));

  // Tarea que procesa las respuestas
  xTaskCreatePinnedToCore(accessCheckResponseTask, "AccessResp", 2048, nullptr,
                          2, nullptr, 0);
  Serial.println(F("[AM_CTRL] Tarea AccessResp creada."));
}
