Davidrp23/LoRa-Smart-Irrigation-Network/firmware/Mota/sensors.h

#pragma once
#include <cstdint>

//=============================
//            GPS
//=============================
#include <HardwareSerial.h>
#include "HT_TinyGPS++.h"

#define GPS_MOSFET_PIN 48
#define GPS_RX_PIN 6 
#define GPS_TX_PIN 7 
#define GPS_BAUD   9600 
#define GPS_TIMEOUT 180000

struct GpsData {
    double latitude;
    double longitude;
    double altitude;
    uint32_t satellites;
    bool isValid;
};

bool gpsInit();
bool getGpsCoordinates(GpsData &data, uint32_t timeoutMs);

//=============================
//           HUMEDAD
//=============================
#define HUM_MOSFET_PIN 47
#define HUM_READ_PIN 5
#define HUM_READ_ITERATIONS 20

// Valores de Calibración del Sensor de Humedad
//#define SENSOR_SECO 580 // Valor de lectura en turba muy seca (0%)
//#define SENSOR_AGUA 60 // Valor en turba recien regada (100%)

#define SENSOR_SECO 446 // Valor de lectura en arcilloso seco (0%)
#define SENSOR_AGUA 40 // Valor sumergido en arcilloso recien regado (100%)

struct humData {
    uint8_t percentage;
    size_t rawValue;
    bool isValid;
};

bool humInit();
void readHum(humData &data);
