Davidrp23/LoRa-Smart-Irrigation-Network/firmware/Router/network.cpp

#include "config.h"
#include "network.h"
#include "storage.h"
#include "rtc_sync.h"

//Router params
size_t connectedClients[MAX_CLIENTS];
std::vector<TimestampedSensorsData> motasDataQueue; //Cola para almacenar los datos de las motas (con timestamp del router)
std::vector<ConfData> motasConf; //Cola para almacenar las configuraciones de las motas
std::vector<ClientCryptoState> clientCryptoStates;

uint8_t activeClients = 0;
NetworkData NETWORK_DATA;

//--------------------------------------------------Clients Managment--------------------------------------------------

//Devuelve la posicion del cliente en la lista ( >= 0 ) si estaba presente, -1 en caso contrario
char getClientIndex(const size_t client){
  xSemaphoreTake(networkMutex, portMAX_DELAY);
  char result = -1;
  for(uint8_t c = 0 ; c < activeClients; c++ ){ //Para que no de muchas vueltas, en vez de poner MAX_CLIENT podemos poner el numero de clientes activos, pero debemos tener el buffer siempre compacto
    if(connectedClients[c] == client){                //Ver la funcion de eliminacion de clientes
      result = c;
      break;
    }
  }
  xSemaphoreGive(networkMutex);
  return result;
}

void addClient(const size_t client){
  xSemaphoreTake(networkMutex, portMAX_DELAY);
  connectedClients[activeClients] = client;
  activeClients++;
  xSemaphoreGive(networkMutex);
}

char getClientCryptoStateIndex(size_t client) {
  xSemaphoreTake(networkMutex, portMAX_DELAY);
  for (size_t i = 0; i < clientCryptoStates.size(); i++) {
    if (clientCryptoStates[i].id == client) {
      xSemaphoreGive(networkMutex);
      return i;
    }
  }
  ClientCryptoState newState = {client, 0, 0};
  clientCryptoStates.push_back(newState);
  char result = clientCryptoStates.size() - 1;
  xSemaphoreGive(networkMutex);
  return result;
}

//Elimina un cliente. Coje al ultimo cliente de la lista y lo pone en la posicion del cliente que se va a eliminar, para tener siempre el array compacto.
bool deleteClient(const size_t client){
  char pos = getClientIndex(client);
  if(pos >= 0){
    xSemaphoreTake(networkMutex, portMAX_DELAY);
    connectedClients[pos] = connectedClients[activeClients - 1];
    connectedClients[activeClients - 1] = 0;
    activeClients--;
    xSemaphoreGive(networkMutex);
    return true;
  }
  return false;
}

void parseBigPacketResponse(String response){

  JsonDocument doc; // Json dinamico , version 7
  DeserializationError error = deserializeJson(doc, response);

  if (error) {
    Serial.print("Error al parsear el big-packet: ");
    Serial.println(error.c_str());
    return;
  }

  // --- Calibración automática del reloj interno ---
  // El backend envía "time" (epoch Unix) cuando detecta que el reloj del
  // router está desfasado más de 5 minutos. Este campo viaja a nivel raíz
  // del JSON, fuera del array "conf", porque es una corrección automática
  // del sistema y no una configuración del usuario.
  if (doc.containsKey("time")) {
    uint32_t serverTime = doc["time"];
    rtcSyncCalibrate(serverTime);
    Serial.printf("[RTC_SYNC] Reloj calibrado desde backend: epoch=%u\n", serverTime);
  }

  JsonArray confArray = doc["conf"];

  for (JsonObject item : confArray) {
    // Seguridad básica
    if (!item.containsKey("tg") || !item.containsKey("id")) continue; 

    const char* tag = item["tg"];
    
    if (strcmp(tag, "r") == 0) { //Aplicamos la configuracion del router

      if((size_t)item["id"] == routerId){ //Comprobamos que este router sea el target
        
        Serial.println("El servidor ha mandado un paquete de configuracion para este router.");

        uint16_t versionDeseada = (uint16_t)item["v"];

        uint16_t versionCopy = 0;

        if (xSemaphoreTake(statsMutex, (TickType_t)10) == pdTRUE) {
          versionCopy = version; //Una vez aplicamos los cambios actualizamos la version
          xSemaphoreGive(statsMutex);
        }

        if (item.containsKey("p") && versionDeseada > versionCopy) { //Parametros de configuracion, comprobamos si la version del paquete es mayor a la actual (nuevos cambios)

          numChannel = item["p"]["c"] | numChannel;
          channel = channelList[numChannel];
          isPublic = item["p"]["eP"] | isPublic;

          if(item["p"].containsKey("s")){
            // Usar strncpy es más seguro que mempcpy para cadenas de texto
            strncpy(SSID, item["p"]["s"], SSID_LENGTH - 1);
            SSID[SSID_LENGTH - 1] = '\0'; // Asegurar el terminador nulo
          }

          //Actualizamos NETWORK_DATA usado en los beacon frames
          strncpy(NETWORK_DATA.SSID, SSID, SSID_LENGTH);
          NETWORK_DATA.isPublic = isPublic;

          Radio.SetChannel( channel );

          if (xSemaphoreTake(statsMutex, (TickType_t)10) == pdTRUE) {
            version = versionDeseada; //Una vez aplicamos los cambios actualizamos la version
            xSemaphoreGive(statsMutex);
          }
          
          saveRouterConfig(); // Guardamos los cambios en flash
          Serial.println("Configuracion de Router actualizada y guardada en flash.");

        }else{
          Serial.printf("No hay configuraciones o la version de configuracion para el router es antigua [versionServidor: %u | versionActual: %u]. Descartando...\n",(unsigned int) versionDeseada, (unsigned int) versionCopy);
        }

      }
    }//Motas
    else if (strcmp(tag, "m") == 0) { // Aplicamos la configuración para motas
      
      size_t targetMoteId = item["id"];
      int index = -1;

      xSemaphoreTake(networkMutex, portMAX_DELAY);

      // 1. Buscamos si la mota ya tiene una configuración en la cola
      for (size_t i = 0; i < motasConf.size(); i++) {
        if (motasConf[i].id == targetMoteId) {
          index = i;
          break;
        }
      }

      // 2. Si la mota NO existe en nuestra lista
      if (index == -1) {
        
        // Comprobamos el límite de MAX_CLIENTS
        if (motasConf.size() >= MAX_CLIENTS) {
          Serial.printf("Aviso: No se pueden guardar más configs (Max %d alcanzado).\n", MAX_CLIENTS);
          xSemaphoreGive(networkMutex);
          continue; // Pasamos a la siguiente iteración del for
        }

        ConfData nuevaConf;
        nuevaConf.router = routerId; // Siempre asignamos el ID de este router
        nuevaConf.id = targetMoteId;
        nuevaConf.version = item["v"];

        nuevaConf.sendInterval = 0; // 0 significará "Mantener actual", no tiene sentido un sendInterval de 0 minutos
        nuevaConf.allowPublicConn = -1; // La mota mantiene su configuracion por defecto
        
        if (item.containsKey("p")) {
          if (item["p"].containsKey("f")) {
            nuevaConf.sendInterval = item["p"]["f"];
          }
          if (item["p"].containsKey("cP")) {
            nuevaConf.allowPublicConn = item["p"]["cP"];
          }
        }

        motasConf.push_back(nuevaConf);

      } 
      // 3. Si la mota YA existe, actualizamos SOLO los valores que vengan en el JSON
      else {
        
        if (item.containsKey("v")) {
          motasConf[index].version = item["v"];
        }

        if (item.containsKey("p")) {
          // Comprobamos explícitamente cada campo para no sobreescribir con 0/false si falta
          if (item["p"].containsKey("f")) {
            motasConf[index].sendInterval = item["p"]["f"];
          }
          if (item["p"].containsKey("cP")) {
            motasConf[index].allowPublicConn = item["p"]["cP"];
          }
        }
      }

      xSemaphoreGive(networkMutex);
    }
  }
  if (xSemaphoreTake(statsMutex, (TickType_t)10) == pdTRUE) {
    shared_waiting_conf = motasConf.size();
    xSemaphoreGive(statsMutex);
  }
}

//void makeBigPacket()

//Funcion para buscar la configuracion de una mota, devuelve su configuracion pendiente o una configuracion con id = 0 en caso contrario 
ConfData searchMotaConf(size_t id) {
  ConfData result;
  result.id = 0;

  xSemaphoreTake(networkMutex, portMAX_DELAY);
  for (size_t i = 0; i < motasConf.size(); i++) {
    if (motasConf[i].id == id) {
      result = motasConf[i];
      break;
    }
  }
  xSemaphoreGive(networkMutex);
  
  return result;
}

//Funcion para eliminar la configuracion de una mota
void deleteMotaConf(size_t id) {
  xSemaphoreTake(networkMutex, portMAX_DELAY);
  for (size_t i = 0; i < motasConf.size(); i++) {
    if (motasConf[i].id == id) {
      motasConf.erase(motasConf.begin() + i);
      if (xSemaphoreTake(statsMutex, (TickType_t)10) == pdTRUE) {
        shared_waiting_conf = motasConf.size();
        xSemaphoreGive(statsMutex);
      }
      break;
    }
  }
  xSemaphoreGive(networkMutex);
}
