Davidrp23/LoRa-Smart-Irrigation-Network/firmware/Mota/images.h

#define image_width  128
#define image_height 53
static unsigned char image_bits[] PROGMEM = {
 0x00,0x00,0x00,0x00,0x00,0x00,0x80,0xff,0xff,0x00,0x00,0x00,
 0x00,0x00,0x00,0x00,0x00,0x00,0x00,0x00,0x00,0xe0,0xff,0xff,
 0xff,0xff,0x03,0x00,0x00,0x00,0x00,0x00,0x00,0x00,0x00,0x00,
 0xc0,0xff,0x01,0x00,0x00,0x80,0xff,0x01,0x00,0x00,0x00,0x00,
 0x00,0x00,0x00,0x00,0xfc,0x0b,0x00,0x00,0x00,0x00,0xe0,0x1f,
 0x00,0x00,0x00,0x00,0x00,0x00,0x00,0x80,0x1f,0x00,0xf0,0xff,
 0xff,0x07,0x00,0xfc,0x00,0x00,0x00,0x00,0x00,0x00,0x00,0x00,
 0x00,0xe0,0xff,0x01,0xc0,0xff,0x07,0x00,0x00,0x00,0x00,0x00,
 0x00,0x00,0x00,0x00,0x00,0xff,0x00,0x00,0x00,0x80,0x7f,0x00,
 0x00,0x00,0x00,0x00,0x00,0x00,0xc0,0x03,0x80,0x07,0x00,0x00,
 0x00,0x00,0xf0,0x01,0xf0,0x01,0x00,0x00,0x00,0x00,0xf0,0x01,
 0x00,0x00,0xfc,0xff,0xff,0x0f,0x00,0x00,0xc0,0x07,0x00,0x00,
 0x00,0x00,0x7c,0x80,0x07,0xc0,0x3f,0x00,0x00,0xff,0x01,0xe0,
 0x00,0x1f,0x00,0x00,0x00,0x00,0x1e,0xc0,0x07,0x00,0x00,0x00,
 0x00,0x00,0x00,0xe0,0x03,0x3c,0x00,0x00,0x00,0x00,0x0f,0x70,
 0x00,0x00,0x00,0x00,0x00,0x00,0x00,0x80,0x07,0xe8,0x00,0x00,
 0x00,0xc0,0x07,0x7c,0x00,0x00,0x00,0x00,0x00,0x00,0x00,0x00,
 0x1f,0xf0,0x01,0x00,0x00,0xc0,0x03,0x3e,0x00,0xff,0x01,0x00,
 0x00,0x80,0xff,0x00,0x3e,0xe0,0x03,0x00,0x00,0xe0,0x01,0x1e,
 0x00,0xc7,0xff,0x00,0x00,0xff,0x71,0x00,0x7c,0xc0,0x03,0x00,
 0x00,0xf0,0x01,0x0f,0x80,0x0f,0xe0,0x03,0xe0,0x03,0x70,0x00,
 0x78,0x80,0x07,0x00,0x00,0xf0,0x80,0x0f,0x00,0x1e,0x00,0x1e,
 0x38,0x00,0x3c,0x00,0xf0,0x80,0x0f,0x00,0x00,0xf0,0x80,0x0f,
 0x00,0x78,0xf8,0x38,0x1e,0x1f,0x0e,0x00,0xf0,0x80,0x0f,0x00,
 0x00,0xf0,0x80,0x07,0x00,0xe0,0xc1,0x77,0xf7,0xc3,0x07,0x00,
 0xf0,0x80,0x0f,0x00,0x00,0xf0,0x80,0x0f,0x00,0x00,0x3f,0xfe,
 0x3f,0xfe,0x00,0x00,0xf0,0x80,0x0f,0x00,0x00,0xf0,0x00,0x0f,
 0x00,0x00,0xe0,0xff,0xff,0x03,0x00,0x00,0x78,0x80,0x07,0x00,
 0x00,0xf0,0x01,0x1f,0x00,0x00,0x00,0xe0,0x03,0x00,0x00,0x00,
 0x7c,0xc0,0x07,0x00,0x00,0xe0,0x03,0x3e,0x00,0x00,0x00,0xc0,
 0x01,0x00,0x00,0x00,0x3e,0xc0,0x03,0x00,0x00,0xc0,0x03,0x7c,
 0x00,0x00,0x00,0xe0,0x03,0x00,0x00,0x00,0x1f,0xe0,0x01,0x00,
 0x00,0x80,0x07,0xf0,0x01,0x00,0x00,0x70,0x0f,0x00,0x00,0x80,
 0x0f,0xf0,0x00,0x00,0x00,0x00,0x1f,0xe0,0x07,0x00,0x00,0x3c,
 0x3c,0x00,0x00,0xe0,0x03,0x78,0x00,0x00,0x00,0x00,0x3c,0x80,
 0x1f,0x00,0x00,0x0f,0xf8,0x00,0x00,0xfc,0x00,0x3f,0x00,0x00,
 0x00,0x00,0xf8,0x00,0x1c,0x00,0xc0,0x03,0xe0,0x03,0x00,0x38,
 0x80,0x0f,0x00,0x00,0x00,0x00,0xe0,0x03,0x00,0x00,0xf8,0x00,
 0x00,0x0f,0x00,0x00,0xe0,0x03,0x00,0x00,0x00,0x00,0x80,0x1f,
 0x00,0x00,0x3c,0x00,0x00,0x3c,0x00,0x00,0xfc,0x00,0x00,0x00,
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

 const char SerialLogoFlora[] PROGMEM = 
    "..............................................................................\n"
    "..............................................................................\n"
    "..............................................................................\n"
    "...............................@@@@@@@@@@.....................................\n"
    ".........................@@@@@@@%......*@@@@@@@...............................\n"
    ".....................@@@@@....................#@@@@...........................\n"
    "...................@@@.......-@@@@@@@@@@@@+.......@@@.........................\n"
    ".........................@@@@@-..........:@@@@@...............................\n"
    "...............@@......@@@....................@@@......@@*....................\n"
    ".............@@@.............@@@@@@@@@@@@@@.............@@@...................\n"
    "............@@*....@@......@@@............@@@......@@.....@@..................\n"
    "...........@@:...+@@................................@@@....@@.................\n"
    "..........@@@....@@..................................@@@....@@................\n"
    "..........@@....@@......@@@@@@............@@@@@@@.....@@....@@-...............\n"
    ".........@@:...@@%......@@....-@@......@@@....-@.......@@....@@...............\n"
    ".........@@....@@........@+...#..@@..*@:..#...@@.......@@....@@...............\n"
    ".........@@....@@.........@@..@@@.@@@@.@@@..@@-........@@....@@...............\n"
    ".........@@....@@...........@@@..@@@@@@+.@@@%..........@@....@@...............\n"
    ".........@@....@@%.............-@@@@@@@@#..............@@....@@...............\n"
    ".........:@@....@@.................@@.................@@....@@@...............\n"
    "..........@@.....@@................@@+...............@@@....@@................\n"
    "...........@@....:@@.............+@@-@@.............@@@....@@.................\n"
    "............@@.....@@@..........@@....@@..........@@@.....@@:.................\n"
    ".............@@@.....@.........@@......@@-........@=....:@@...................\n"
    "..............@@@............@@%.........@@............@@@....................\n"
    "................@@..........@@............@@..........@@......................\n"
    "...........................@@..............@@.................................\n"
    "...........................@-...............@%................................\n"
    "..........................#@..@@............@@................................\n"
    "...........................@@.%@@...........@:................................\n"
    "...........................-@@..@@@@=.....:@@.................................\n"
    ".............................@@@........%@@...................................\n"
    "...............................%@@@@@@@@@.....................................\n"
    "..............................................................................\n"
    "...@@@@@@@@@@@@..@@.........................@@@@@@@@@+........................\n"
    "...@@@...........@@.........................@@......@@@.......................\n"
    "...@@@...........@@.............@@@@@@@.....@@......@@@....%@@@@@@............\n"
    "...@@@@@@@@@@....@@...........@@@.....@@*...@@.....@@@...#@@#....@@@..........\n"
    "...@@@...........@@..........@@+.......@@...@@@@@@@@.....@@.......:@@.........\n"
    "...@@@...........@@..........@@........@@...@@....@@@....@@........@@.........\n"
    "...@@@...........@@...........@@*.....@@@...@@.....+@@:..@@@.....-@@@.........\n"
    "...@@@...........@@@@@@@@@@@...@@@@@@@@.....@@.......@@=...@@@@@@@.@@.........\n"
    "..............................................................................\n"
    "..............................................................................\n"
    "..............................................................................\n";

#define emoji_width  8
#define emoji_height 8

// Icono: Candado Cerrado (Red Privada) - 8x8 píxeles
const unsigned char icon_lock[] PROGMEM = {
  0x3C, 0x42, 0x42, 0xFF, 0xFF, 0xE7, 0xFF, 0xFF
};

// Icono: Candado Abierto (Red Pública) - 8x8 píxeles
const unsigned char icon_unlock[] PROGMEM = {
  0x3C, 0x02, 0x02, 0xFF, 0xFF, 0xE7, 0xFF, 0xFF
};
