Davidrp23/LoRa-Smart-Irrigation-Network/firmware/Router/display.h

#pragma once
#include "config.h"
#include "freertos/FreeRTOS.h"
#include "freertos/semphr.h"
#include "freertos/task.h"
#include "types.h"
#include <Arduino.h>

// Proteger las variables compartidas
extern SemaphoreHandle_t statsMutex;
extern SemaphoreHandle_t buttonStateMutex;
extern SemaphoreHandle_t networkMutex;
extern SemaphoreHandle_t loraTxSemaphore;

// Variables globales protegidas
extern volatile size_t shared_rx;
extern volatile size_t shared_tx;
extern volatile size_t shared_rx_err;
extern volatile size_t shared_tx_err;
extern volatile int16_t shared_rssi;
extern volatile size_t shared_queueFull;
extern volatile uint8_t shared_queueSize;
extern volatile uint8_t shared_waiting_conf;
extern volatile uint16_t shared_channelBusyErrors;
extern volatile int8_t shared_connectedClients;
extern volatile size_t shared_crc_err;
extern volatile size_t shared_crypto_err;
extern size_t shared_lastClient;
extern volatile int8_t shared_coverage; // Cobertura GPRS (CSQ) del AM-036
extern volatile TickType_t
    shared_firstPktTimestamp; // Timestamp (ticks) del primer paquete en cola
// GPS del router (protegida por statsMutex)
extern GpsData shared_gps;
// Fuel Gauge (protegida por statsMutex)
extern BatteryStatus shared_battery;
// extern uint16_t version; declarada en config.h tambien es protegida

// OLED UI
extern uint8_t defaultMenu;

// Button
extern volatile ButtonEvent globalButtonState;

// Funciones
void initializeOled();
void TaskDisplay(void *pvParameters);
void checkButton();
