Davidrp23/LoRa-Smart-Irrigation-Network/firmware/Router/lora_router.h

#pragma once
#include <Arduino.h>
#include "LoRaWan_APP.h"
#include "types.h"
#include "config.h"
#include "network.h"
#include "display.h"

// Definimos cuántos mensajes puede guardar
#define RX_QUEUE_LEN 10 

// Tamaño de cada elemento: el payload crudo + metadatos (size, rssi, snr)
#define RX_MSG_SIZE  sizeof(RxRawPacket)

extern QueueHandle_t rxQueue; //Para inicializarlo en el setup

// Lora chip events functions
void initializeLora();
void OnTxDone( void );
void OnTxTimeout( void );
void OnRxDone( uint8_t *payload, uint16_t size, int16_t rssi, int8_t snr );

// Tarea FreeRTOS que consume la rxQueue y ejecuta toda la lógica de validación y proceso
void loraRxProcessTask(void *pvParameters);

// Protocol functions
void process(LoRaMessage incomingPackage);
uint16_t calculateChecksum(LoRaMessage msg);
void sendControlPacket(messageType type, size_t clientID);
void sendConfigPacket(ConfData configMota);
void sendBeaconResponse();
bool IsChannelFree();
char findChannelNumber(uint32_t ch);

// Debug
void packageToSerial(LoRaMessage pkg, uint16_t size, int16_t rssi, int8_t snr);
