Davidrp23/LoRa-Smart-Irrigation-Network/(commit log)

2025-12-22 Initial Commit - Add docs and Arduino firmware
2026-01-26 add sender prototype code
2026-02-04 Add beacon frame request and beacon frame response logic on router code
2026-02-13 fix bug that allow a node conect to a any network
    [maquinaEstadosMota.ino, routerLora.ino]
2026-02-23 add big-packet logic , add router token authentication, update claim device logic
2026-04-12 working in gps code, mosfet test added
2026-04-16 fix battery read, fixed hum read, fixed gps power (hardware), working on deepsleep code
    [Battery.cpp, maquinaEstadosMota.ino, sensors.cpp, sensors.h]
2026-04-18 router code has been refactorized, add button last activity (power off oled)
2026-04-28 changue add device position to center
2026-04-28 Revert "changue add device position to center"
    This reverts commit d3f6bb5c8c5338d7c8f09ad613f884d346dac830.
2026-04-28 changue add device position to center cm2
2026-04-28 fix url server on sim800l code
    [sim800lSlave.ino]
2026-04-28 fixed a bug that unassigned a device from a plot when the configuration was changed
2026-05-06 add task to sim800l slave that show current state of internal state machine
2026-05-14 add squematic mosfet image
2026-05-14 add more time to obtain gprs in sim800l , change mosfet logic (invert)
    [SerialAM_lib.cpp, sensors.cpp, sim800lSlave.ino]
2026-06-21 Reorganización completa de la estructura del proyecto
