Davidrp23/LoRa-Smart-Irrigation-Network/(notices)

Notices in the files:
README.md:
License: MIT
